zobuj/PortableOfflineTranslator/README.md

# Portable Offline Translator

Portable Offline Translator is a lightweight, offline translation tool designed for quick and easy translations without the need for an internet connection. 

Lab Notebooks are located in the [`doc/notebooks/`](./doc/notebooks/) directory.
