zobuj/PortableOfflineTranslator/doc/notebooks/lorenzo/images/lcd_initial.jpeg

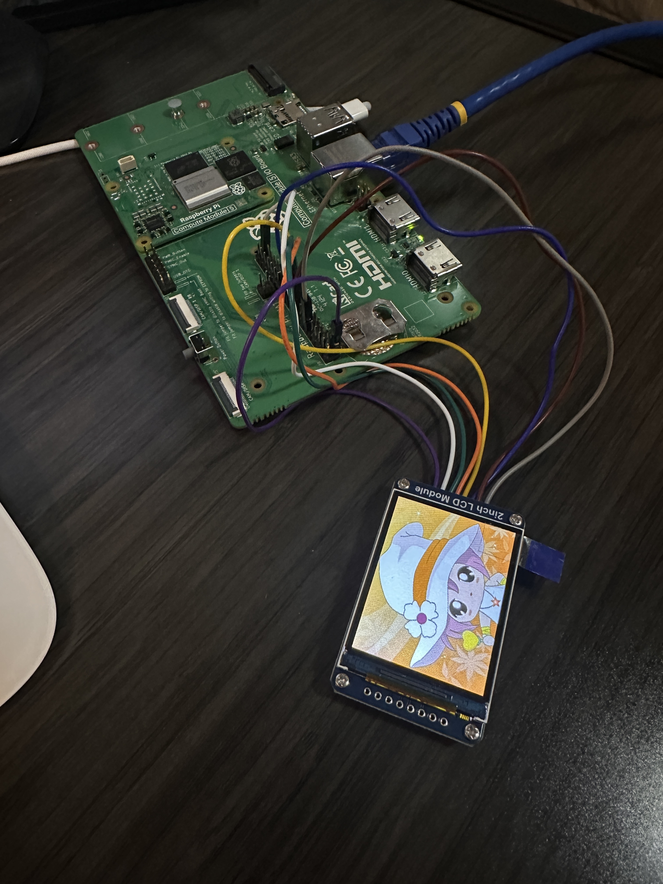
doc/notebooks/lorenzo/images/lcd_initial.jpeg
