zobuj/PortableOfflineTranslator/src/rspcm/images/io_GPIO_header.png

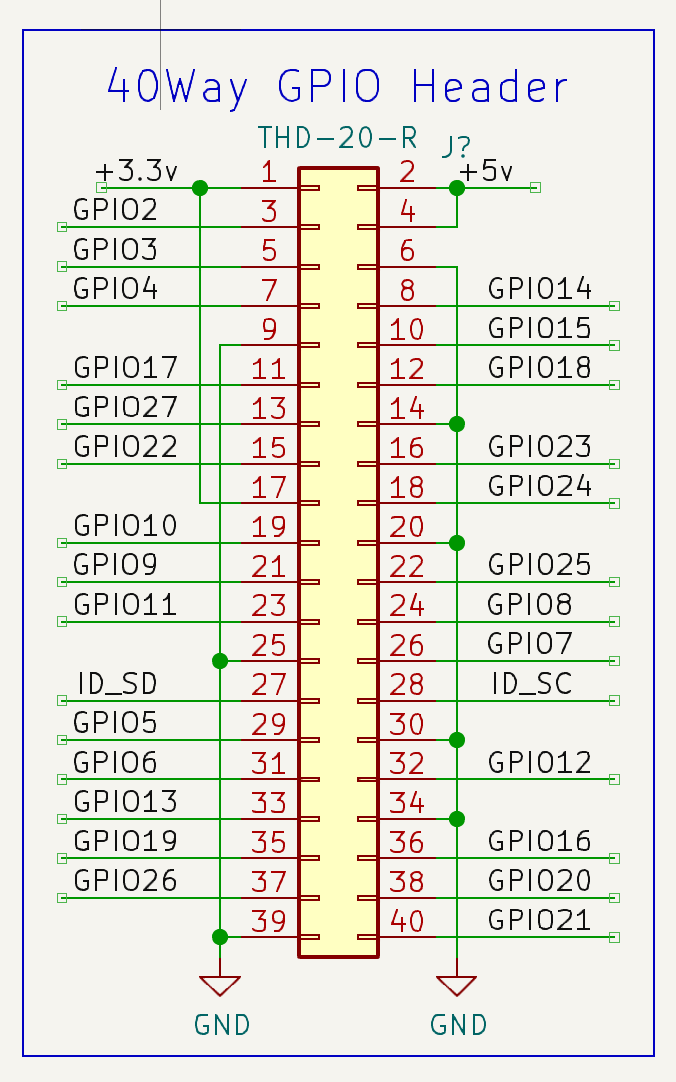
src/rspcm/images/io_GPIO_header.png
