zobuj/PortableOfflineTranslator/src/user_interface/lcd/images/output.bmp

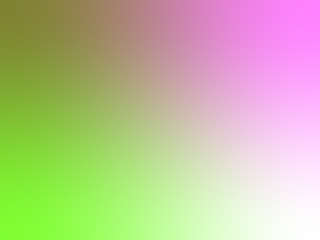
src/user_interface/lcd/images/output.bmp
