zobuj/PortableOfflineTranslator/pcb/PCB_Backup/Symbols:Footprints/ESP32_S3/ESP32-S3.step

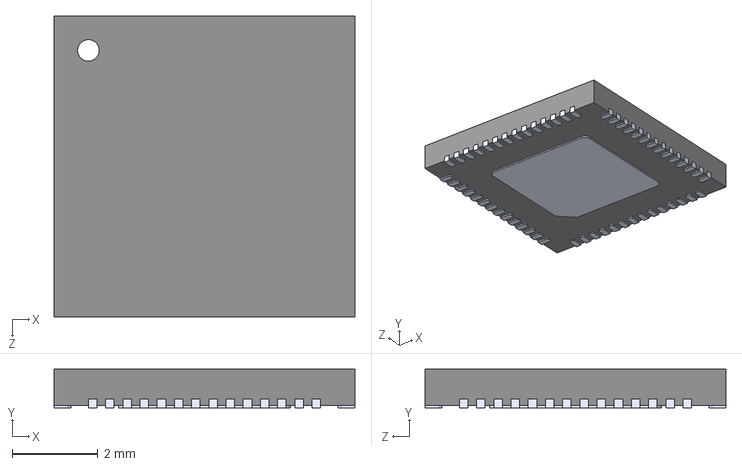
[picture p25: CAD file, 2025-05-08]
pcb/PCB_Backup/Symbols:Footprints/ESP32_S3/ESP32-S3.step
7.00 x 0.9 x 7.00 mm
