zobuj/PortableOfflineTranslator/pcb/PCB_Backup/Symbols:Footprints/ESP32_S3_WROOM_1_N8R8/ESP32-S3-WROOM-1-N8R8.step

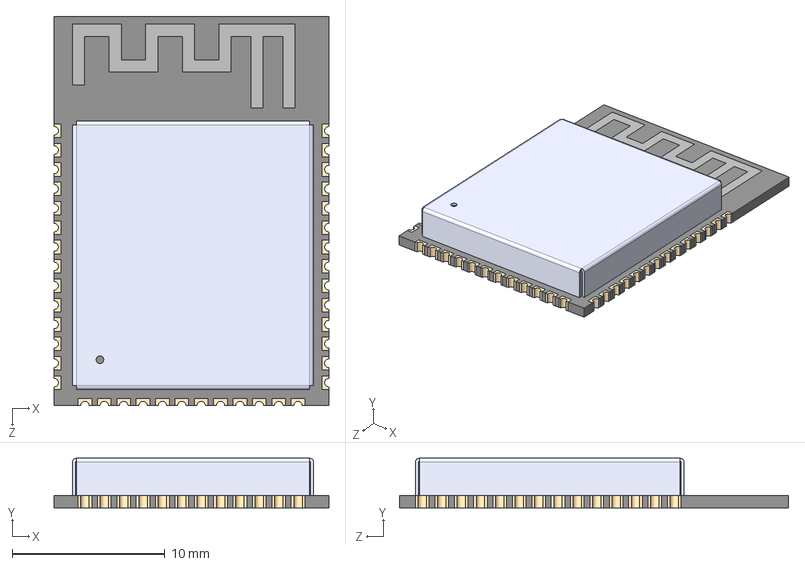
[picture p26: CAD file, 2025-05-08]
pcb/PCB_Backup/Symbols:Footprints/ESP32_S3_WROOM_1_N8R8/ESP32-S3-WROOM-1-N8R8.step
18.0 x 3.25 x 25.5 mm
