zobuj/PortableOfflineTranslator/pcb/Portable Offline Translator/Symbols/Battery Connector/B2B-XH-A.step

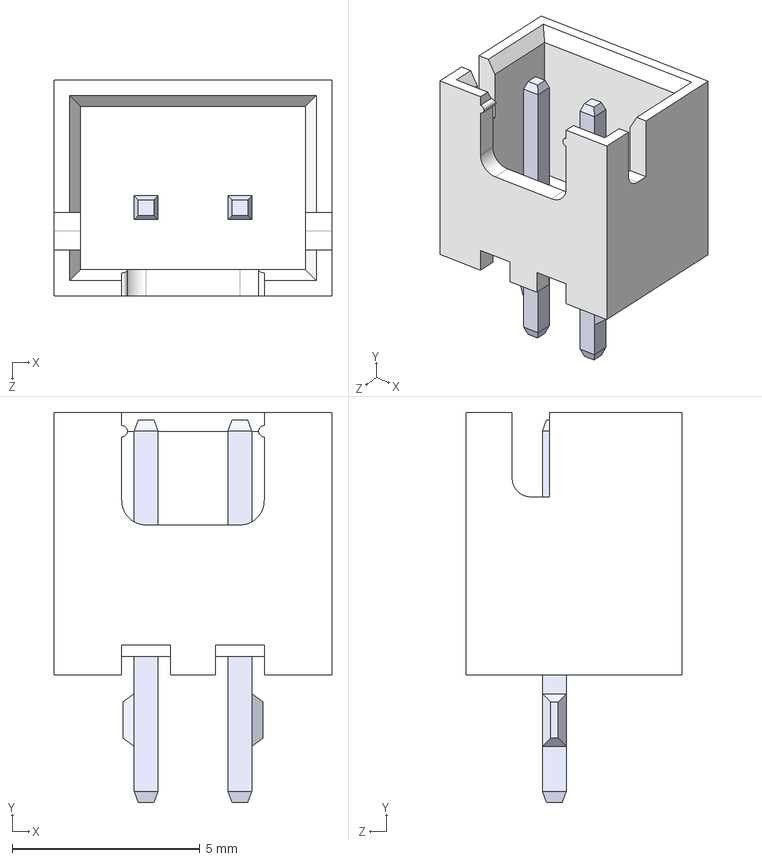
[picture p27: CAD file, 2025-04-03]
pcb/Portable Offline Translator/Symbols/Battery Connector/B2B-XH-A.step
7.40 x 10.4 x 5.75 mm
