zobuj/PortableOfflineTranslator/pcb/Portable Offline Translator/Symbols/SPH0645LM4H-B(Microphone)/SPH0645LM4H-B.step

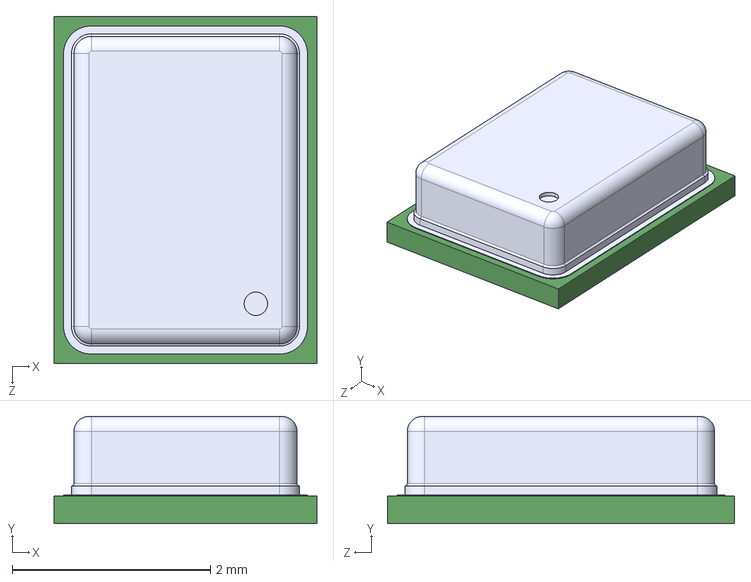
[picture p28: CAD file, 2025-04-03]
pcb/Portable Offline Translator/Symbols/SPH0645LM4H-B(Microphone)/SPH0645LM4H-B.step
2.65 x 1.08 x 3.50 mm
