zobuj/PortableOfflineTranslator/pcb/Portable Offline Translator/Symbols/CM5_Connector/10164227-1001A1RLF.step

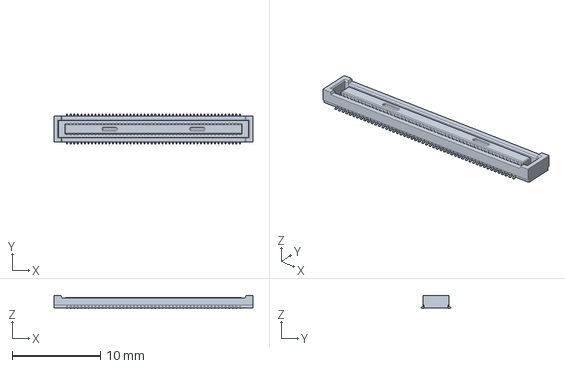
[picture p29: CAD file, 2025-03-11]
pcb/Portable Offline Translator/Symbols/CM5_Connector/10164227-1001A1RLF.step
22.6 x 3.38 x 1.45 mm
