zobuj/PortableOfflineTranslator/pcb/Portable Offline Translator/Symbols/MAX98357AETE_T/MAX98357AETE_T.step

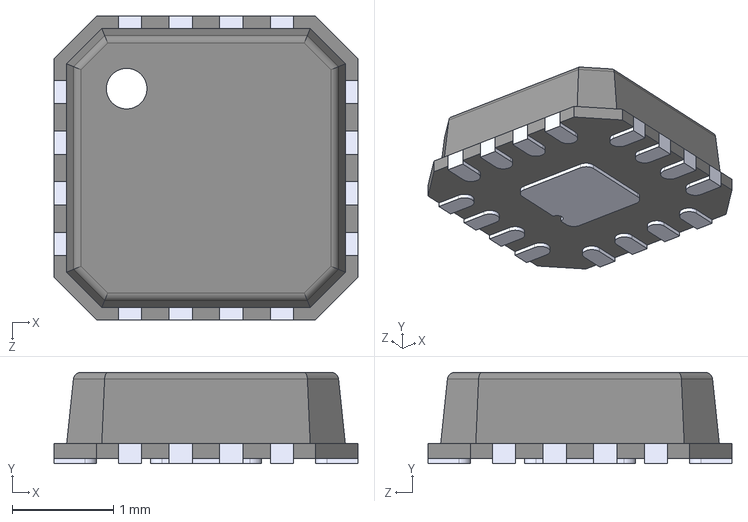
[picture p30: CAD file, 2025-03-22]
pcb/Portable Offline Translator/Symbols/MAX98357AETE_T/MAX98357AETE_T.step
3.00 x 0.9 x 3.00 mm
