zobuj/PortableOfflineTranslator/(list of files, cad)

Other CAD files:
pcb/Portable Offline Translator/Symbols/LIB_STM32F407IET6/STM32F407IET6/Allegro/qfp50p2600x2600x160-176n.psm
pcb/Portable Offline Translator/Symbols/LIB_STM32F407IET6/STM32F407IET6/DEHDL/stm32f407iet6/chips/chips.prt
