zobuj/PortableOfflineTranslator/output/pipeline_memory_usage_high.png

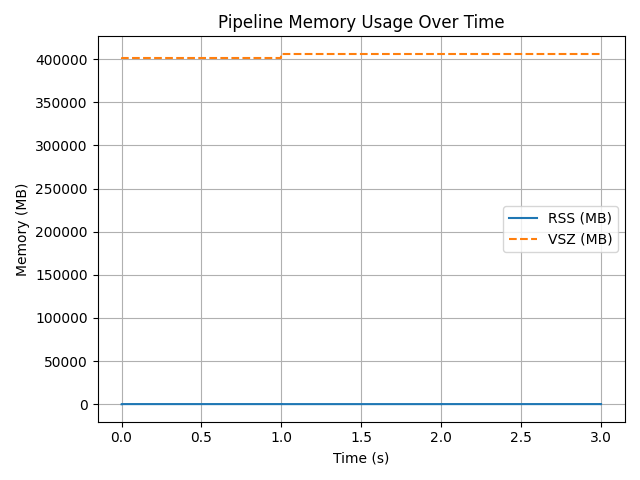
output/pipeline_memory_usage_high.png
