zobuj/PortableOfflineTranslator/pcb/PCB_Backup/PlanB/PlanB.kicad_pcb

## KiCad design pcb/PCB_Backup/PlanB/PlanB.kicad_pcb (2025-05-08)

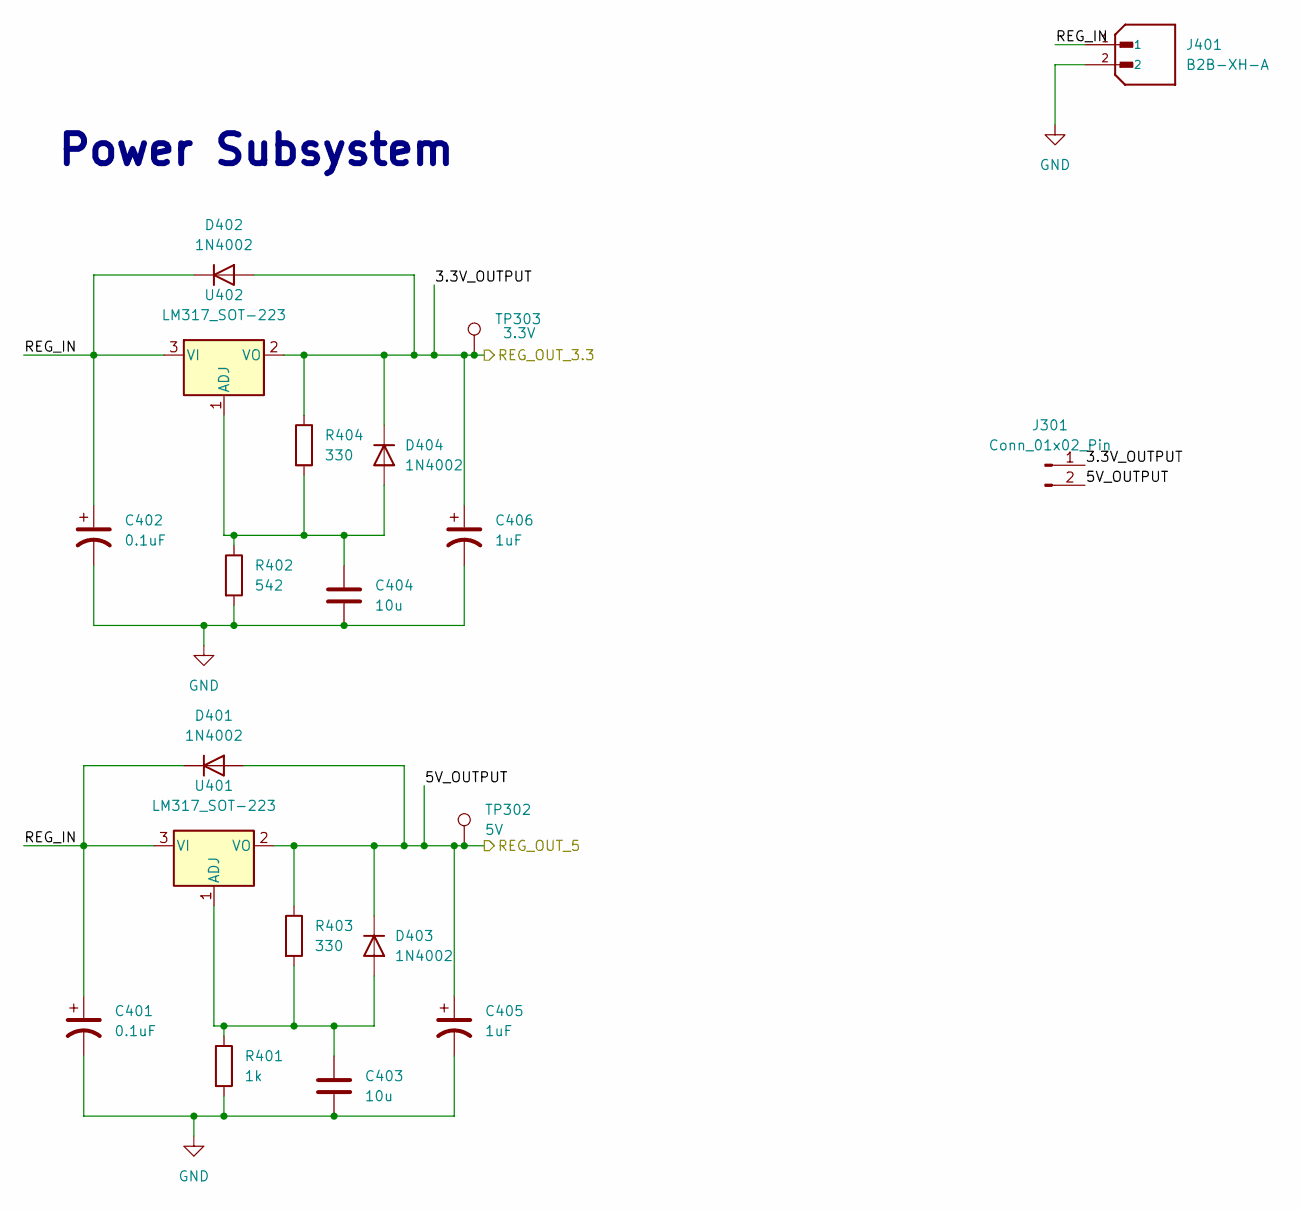
[picture p32: schematic PowerSS.kicad_sch]

Parts:
C401, C402: 0.1uF; C_0603_1608Metric_Pad1.08x0.95mm_HandSolder
C403, C404: 10u; C_0603_1608Metric_Pad1.08x0.95mm_HandSolder
C405, C406: 1uF; C_0603_1608Metric_Pad1.08x0.95mm_HandSolder
D401, D402, D403, D404: 1N4002; D_DO-41_SOD81_P10.16mm_Horizontal
J301: Conn_01x02_Pin; PinHeader_1x02_P2.54mm_Vertical
J401: B2B-XH-A; JST_B2B-XH-A; PARTREV N/A
R401: 1k; R_0805_2012Metric_Pad1.20x1.40mm_HandSolder
R402: 542; R_0805_2012Metric_Pad1.20x1.40mm_HandSolder
R403, R404: 330; R_0805_2012Metric_Pad1.20x1.40mm_HandSolder
TP302: 5V; TestPoint_Keystone_5000-5004_Miniature
TP303: 3.3V; TestPoint_Keystone_5000-5004_Miniature
U401, U402: LM317_SOT-223; SOT-223-3_TabPin2

Connections:
+3.3V: C406.1, D402.2 (A), D404.1 (K), J301.1, R404.1, TP303.1, U402.2 (VO); also elsewhere on the board
+5V: C405.1, D401.2 (A), D403.1 (K), J301.2, R403.1, TP302.1, U401.2 (VO)
/PowerSS/REG_IN: C401.1, C402.1, D401.1 (K), D402.1 (K), J401.1, U401.3 (VI), U402.3 (VI)
GND: C401.2, C402.2, C403.2, C404.2, C405.2, C406.2, J401.2, R401.2, R402.2; also elsewhere on the board
unnamed: C403.1, D403.2 (A), R401.1, R403.2, U401.1 (ADJ)
unnamed: C404.1, D404.2 (A), R402.1, R404.2, U402.1 (ADJ)

Notes on the sheet:
Power Subsystem

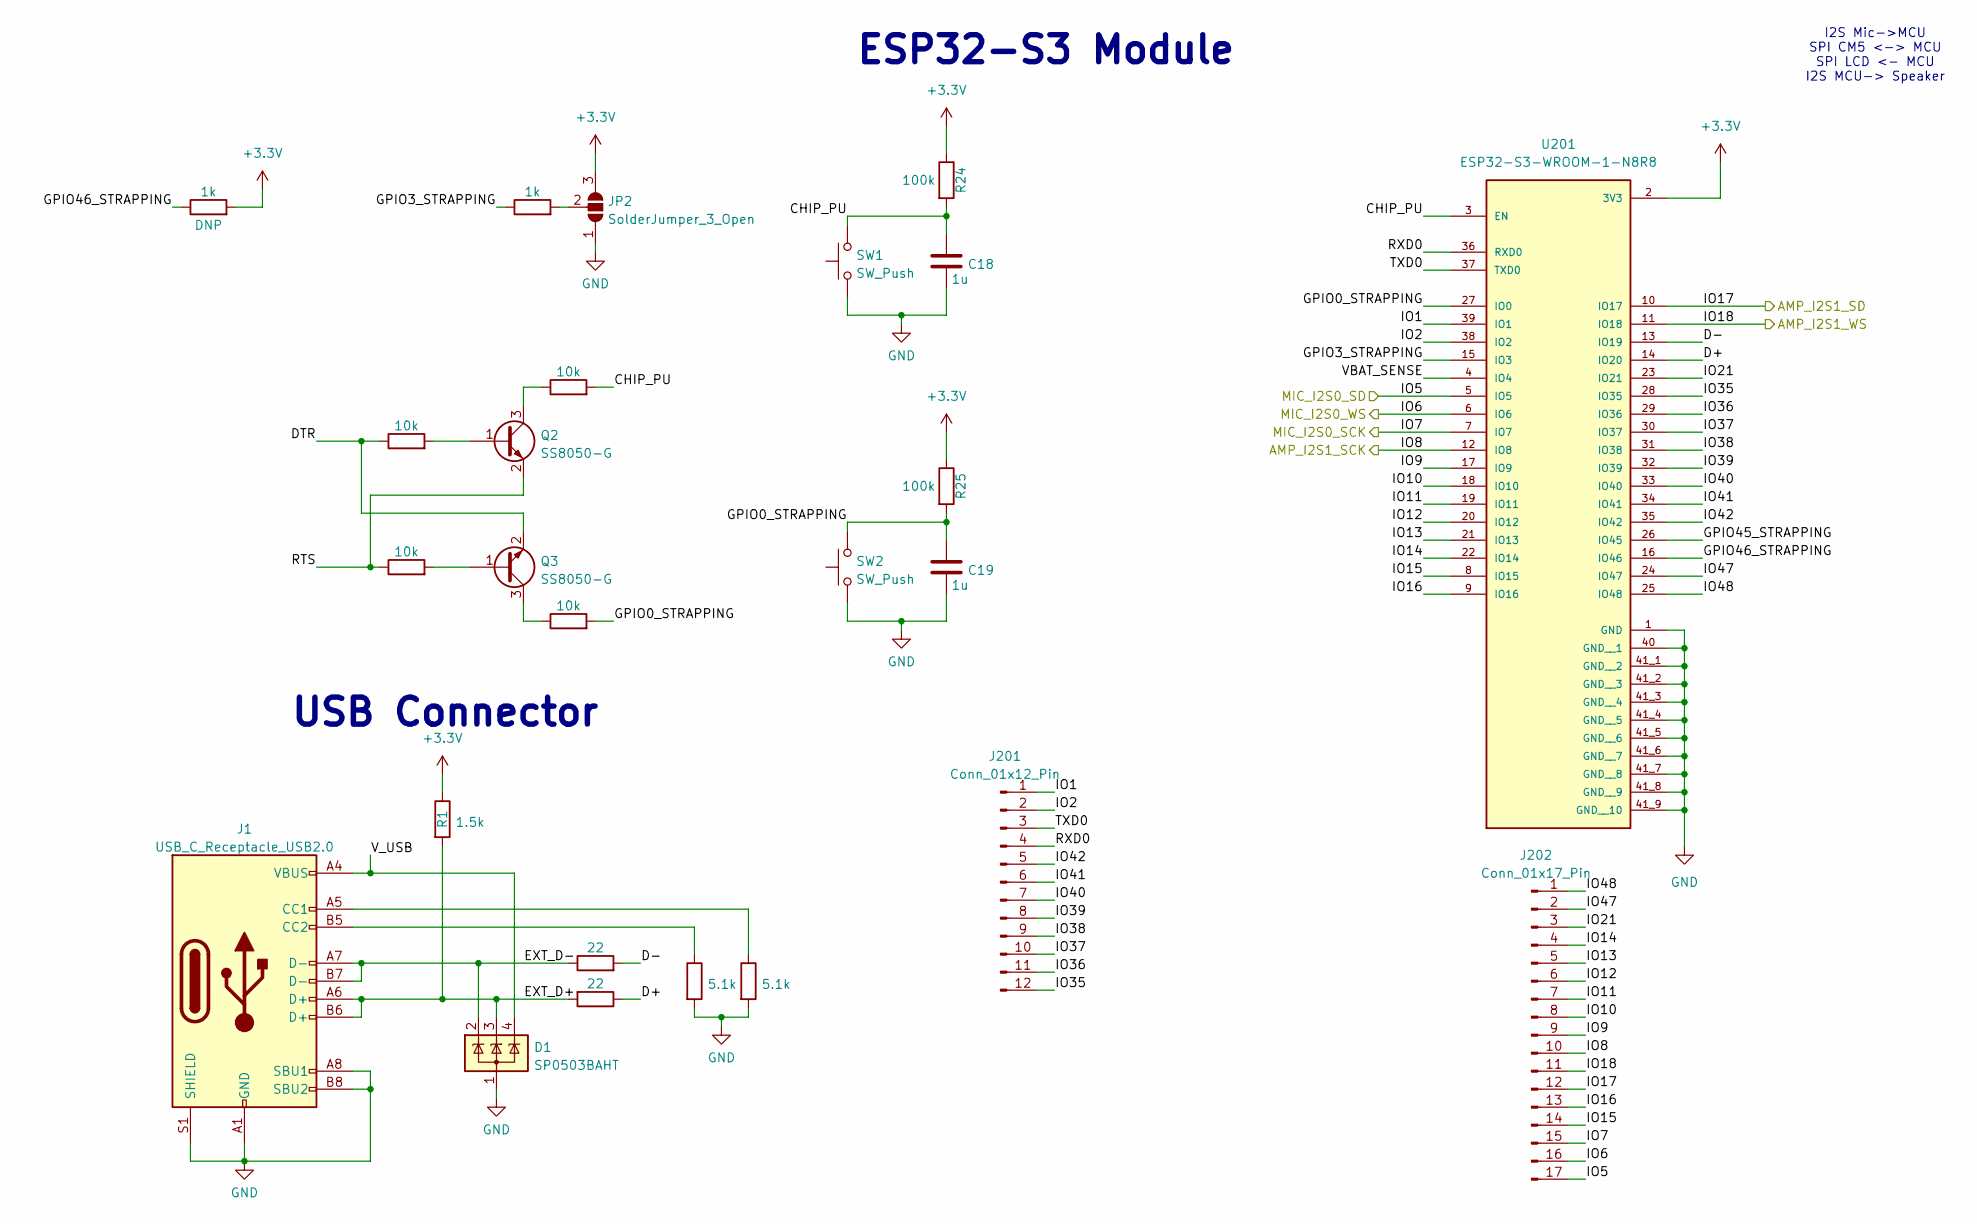
[picture p33: schematic MCU.kicad_sch]

Parts:
C18, C19: 1u; C_0805_2012Metric
D1: SP0503BAHT; SOT-143
J1: USB_C_Receptacle_USB2.0; USB_C_Receptacle_Amphenol_12401610E4-2A_CircularHoles
J201: Conn_01x12_Pin; PinSocket_1x12_P2.54mm_Vertical
J202: Conn_01x17_Pin; PinSocket_1x17_P2.54mm_Vertical
JP2: SolderJumper_3_Open; SolderJumper-3_P2.0mm_Open_TrianglePad1.0x1.5mm
Q2, Q3: SS8050-G; SOT-23
R1: 1.5k; R_0603_1608Metric
R3, R4: 22; R_0603_1608Metric
R7, R8: 5.1k; R_0603_1608Metric
R12, R17: 1k; R_0805_2012Metric
R13, R14, R18, R19: 10k; R_0805_2012Metric
R24, R25: 100k; R_0805_2012Metric
SW1, SW2: SW_Push; SW_SPST_B3S-1000
U201: ESP32-S3-WROOM-1-N8R8; XCVR_ESP32S3WROOM1N8R8

Connections:
+3.3V: JP2.3 (B), R1.1, R12.2, R24.1, R25.1, U201.2 (3V3); also elsewhere on the board
/MCU/CHIP_PU: C18.1, R18.2, R24.2, SW1.2, U201.3 (EN)
/MCU/D+: R4.1, U201.14 (IO20)
/MCU/D-: R3.2, U201.13 (IO19)
/MCU/DTR: Q3.2 (E), R13.1
/MCU/EXT_D+: D1.3 (K), J1.A6 (D+), J1.B6 (D+), R1.2, R4.2
/MCU/EXT_D-: D1.2 (K), J1.A7 (D-), J1.B7 (D-), R3.1
/MCU/GPIO0_STRAPPING: C19.1, R19.2, R25.2, SW2.2, U201.27 (IO0)
/MCU/GPIO3_STRAPPING: R17.1, U201.15 (IO3)
/MCU/GPIO45_STRAPPING: U201.26 (IO45)
/MCU/GPIO46_STRAPPING: R12.1, U201.16 (IO46)
/MCU/IO1: J201.1, U201.39 (IO1)
/MCU/IO2: J201.2, U201.38 (IO2)
/MCU/IO5: J202.17, U201.5 (IO5); also elsewhere on the board
/MCU/IO6: J202.16, U201.6 (IO6); also elsewhere on the board
/MCU/IO7: J202.15, U201.7 (IO7); also elsewhere on the board
/MCU/IO8: J202.10, U201.12 (IO8); also elsewhere on the board
/MCU/IO9: J202.9, U201.17 (IO9)
/MCU/IO10: J202.8, U201.18 (IO10)
/MCU/IO11: J202.7, U201.19 (IO11)
/MCU/IO12: J202.6, U201.20 (IO12)
/MCU/IO13: J202.5, U201.21 (IO13)
/MCU/IO14: J202.4, U201.22 (IO14)
/MCU/IO15: J202.14, U201.8 (IO15)
/MCU/IO16: J202.13, U201.9 (IO16)
/MCU/IO17: J202.12, U201.10 (IO17); also elsewhere on the board
/MCU/IO18: J202.11, U201.11 (IO18); also elsewhere on the board
/MCU/IO21: J202.3, U201.23 (IO21)
/MCU/IO35: J201.12, U201.28 (IO35)
/MCU/IO36: J201.11, U201.29 (IO36)
/MCU/IO37: J201.10, U201.30 (IO37)
/MCU/IO38: J201.9, U201.31 (IO38)
/MCU/IO39: J201.8, U201.32 (IO39)
/MCU/IO40: J201.7, U201.33 (IO40)
/MCU/IO41: J201.6, U201.34 (IO41)
/MCU/IO42: J201.5, U201.35 (IO42)
/MCU/IO47: J202.2, U201.24 (IO47)
/MCU/IO48: J202.1, U201.25 (IO48)
/MCU/RTS: Q2.2 (E), R14.1
/MCU/RXD0: J201.4, U201.36 (RXD0)
/MCU/TXD0: J201.3, U201.37 (TXD0)
/MCU/VBAT_SENSE: U201.4 (IO4)
/MCU/V_USB: D1.4 (K), J1.A4 (VBUS), J1.A9 (VBUS), J1.B4 (VBUS), J1.B9 (VBUS)
GND: C18.2, C19.2, D1.1 (A), J1.A1 (GND), J1.A8 (SBU1), J1.A12 (GND), J1.B1 (GND), J1.B8 (SBU2), J1.B12 (GND), J1.S1 (SHIELD), JP2.1 (A), R7.2, R8.2, SW1.1, SW2.1, U201.1 (GND), U201.40 (GND__1), U201.41_1 (GND__2), U201.41_2 (GND__3), U201.41_3 (GND__4), U201.41_4 (GND__5), U201.41_5 (GND__6), U201.41_6 (GND__7), U201.41_7 (GND__8), U201.41_8 (GND__9), U201.41_9 (GND__10); also elsewhere on the board
unnamed: J1.A5 (CC1), R8.1
unnamed: J1.B5 (CC2), R7.1
unnamed: JP2.2 (C), R17.2
unnamed: Q2.1 (B), R13.2
unnamed: Q2.3 (C), R18.1
unnamed: Q3.1 (B), R14.2
unnamed: Q3.3 (C), R19.1

Notes on the sheet:
I2S Mic->MCU SPI CM5 <-> MCU SPI LCD <- MCU I2S MCU-> Speaker
ESP32-S3 Module
USB Connector

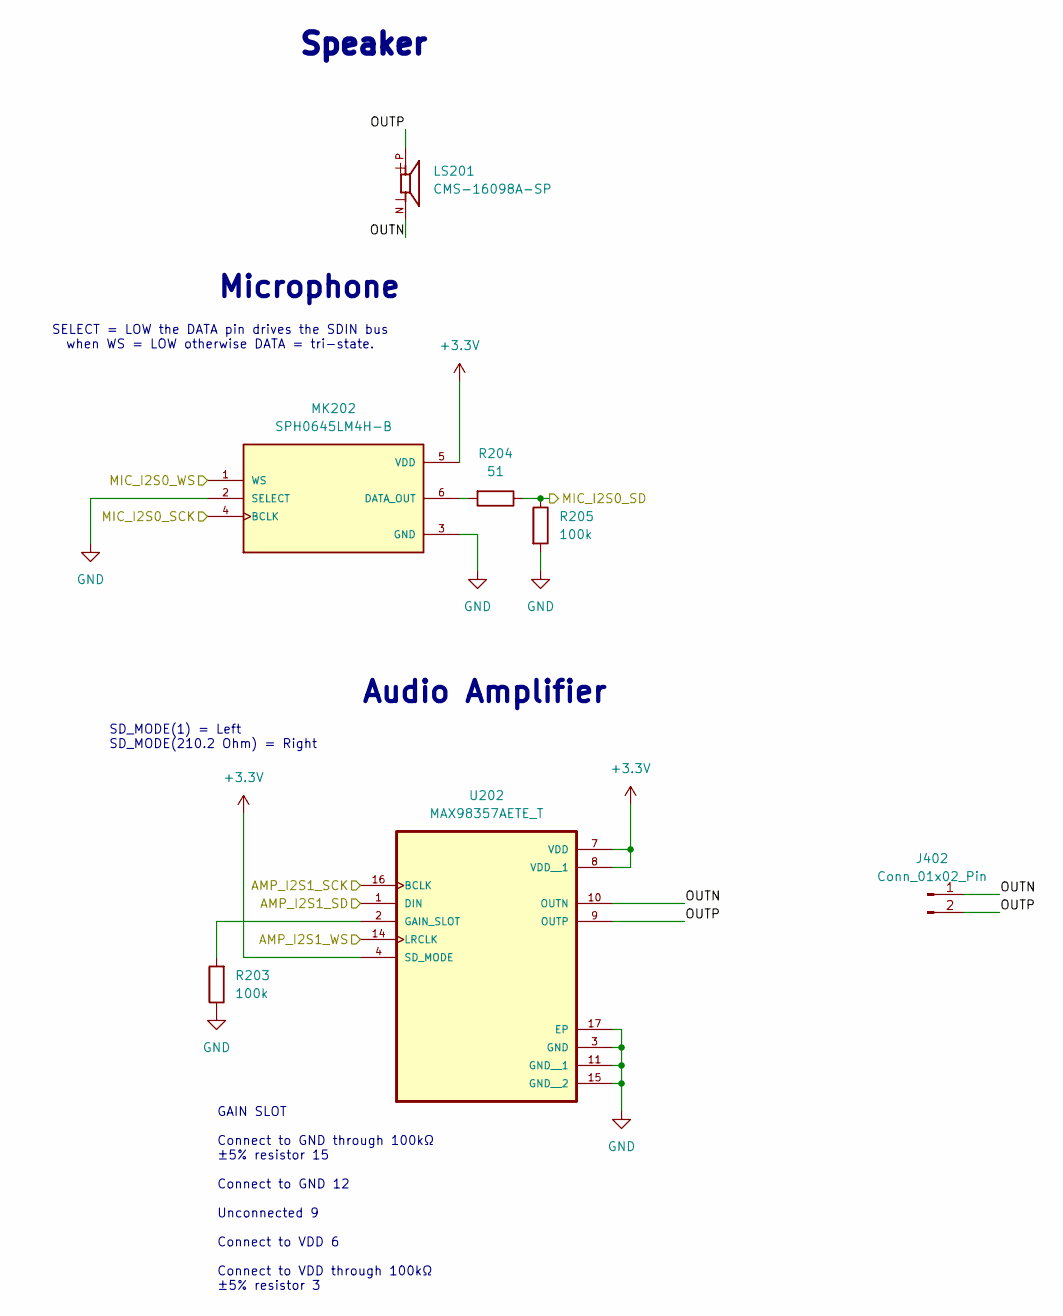
[picture p34: schematic IO.kicad_sch]

Parts:
J402: Conn_01x02_Pin; PinHeader_1x02_P2.54mm_Vertical
LS201: CMS-16098A-SP; CUI_CMS-16098A-SP
MK202: SPH0645LM4H-B; MIC_SPH0645LM4H-B
R203, R205: 100k; R_0805_2012Metric_Pad1.20x1.40mm_HandSolder
R204: 51; R_0805_2012Metric_Pad1.20x1.40mm_HandSolder
U202: MAX98357AETE_T; TQFN-16-1EP_3x3mm_P0.5mm_EP1.23x1.23mm

Connections:
+3.3V: MK202.5 (VDD), U202.4 (SD_MODE), U202.7 (VDD), U202.8 (VDD__1); also elsewhere on the board
/IO/OUTN: J402.1, LS201.N, U202.10 (OUTN)
/IO/OUTP: J402.2, LS201.P, U202.9 (OUTP)
/MCU/IO5: R204.1, R205.1; also elsewhere on the board
/MCU/IO6: MK202.1 (WS); also elsewhere on the board
/MCU/IO7: MK202.4 (BCLK); also elsewhere on the board
/MCU/IO8: U202.16 (BCLK); also elsewhere on the board
/MCU/IO17: U202.1 (DIN); also elsewhere on the board
/MCU/IO18: U202.14 (LRCLK); also elsewhere on the board
GND: MK202.2 (SELECT), MK202.3 (GND), R203.1, R205.2, U202.3 (GND), U202.11 (GND__1), U202.15 (GND__2), U202.17 (EP); also elsewhere on the board
unnamed: MK202.6 (DATA_OUT), R204.2
unnamed: R203.2, U202.2 (GAIN_SLOT)

Notes on the sheet:
Speaker
SELECT = LOW the DATA pin drives the SDIN bus when WS = LOW otherwise DATA = tri-state.
Audio Amplifier
Microphone
GAIN SLOT Connect to GND through 100kΩ ±5% resistor 15 Connect to GND 12 Unconnected 9 Connect to VDD 6 Connect to VDD through 100kΩ ±5% resistor 3
SD_MODE(1) = Left SD_MODE(210.2 Ohm) = Right

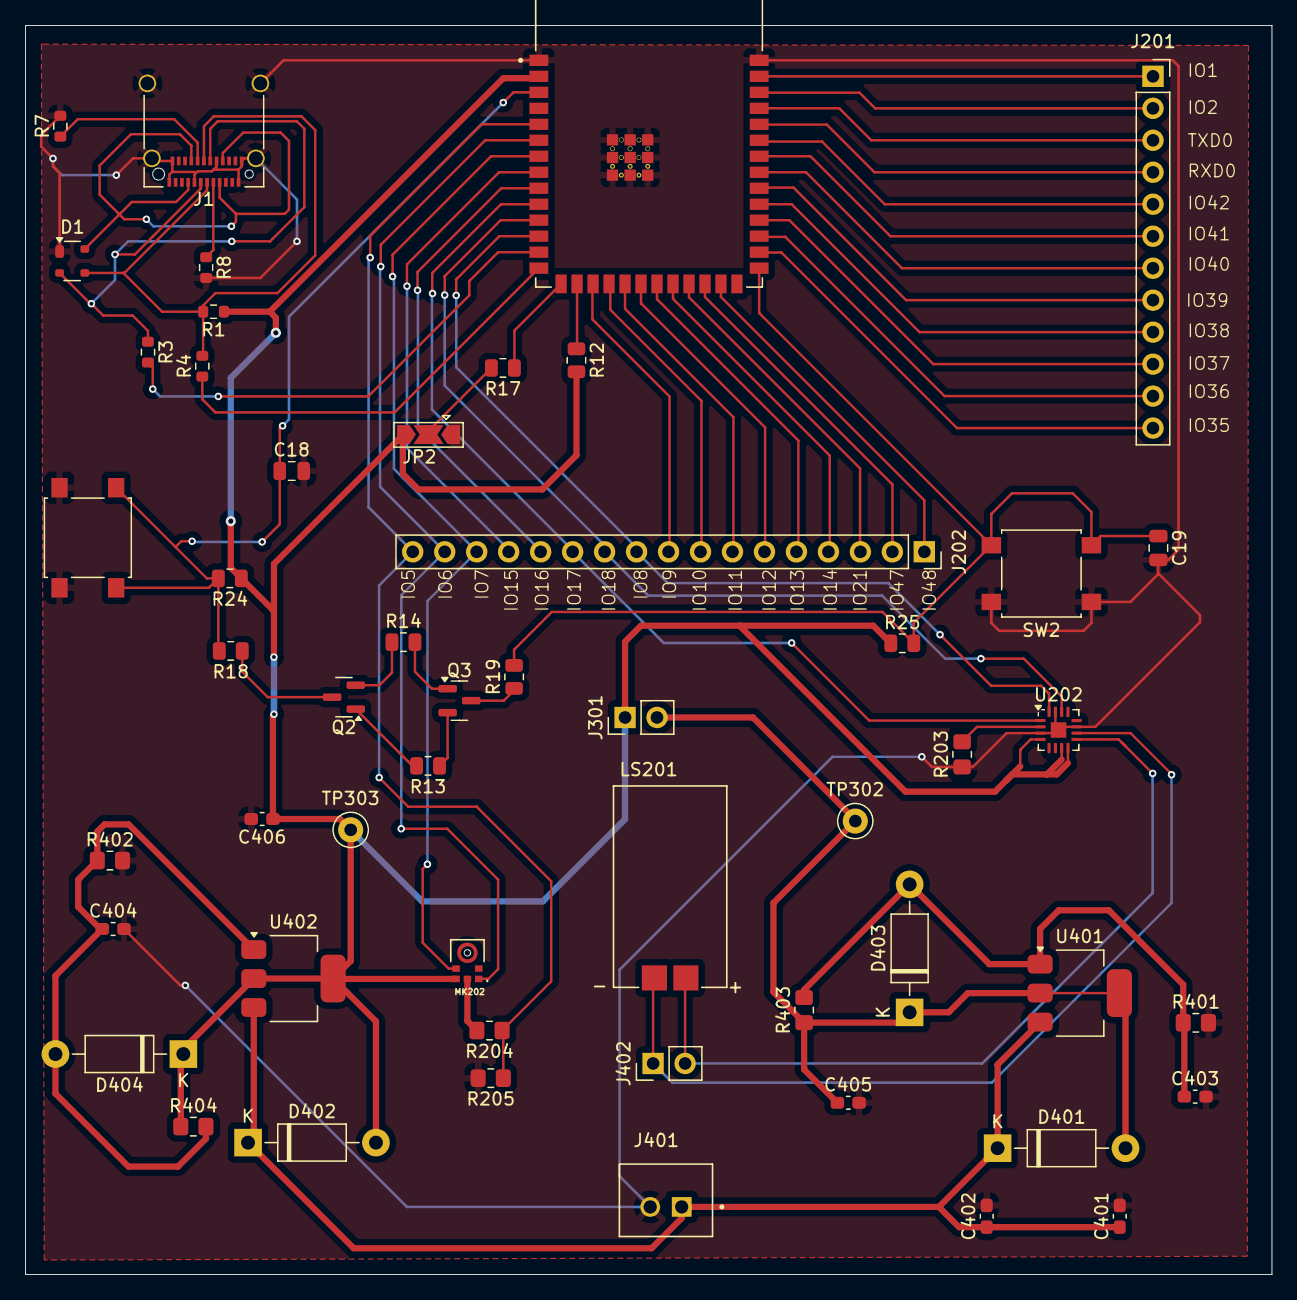
[picture p35: board PlanB.kicad_pcb from above]

Board: 2 copper layers, 99.0 x 99.2 mm, 52 parts (0 on the bottom side), 57 nets.
