zobuj/PortableOfflineTranslator/pcb/Portable Offline Translator/Portable Offline Translator.kicad_pcb

## KiCad design pcb/Portable Offline Translator/Portable Offline Translator.kicad_pcb (2025-04-03)

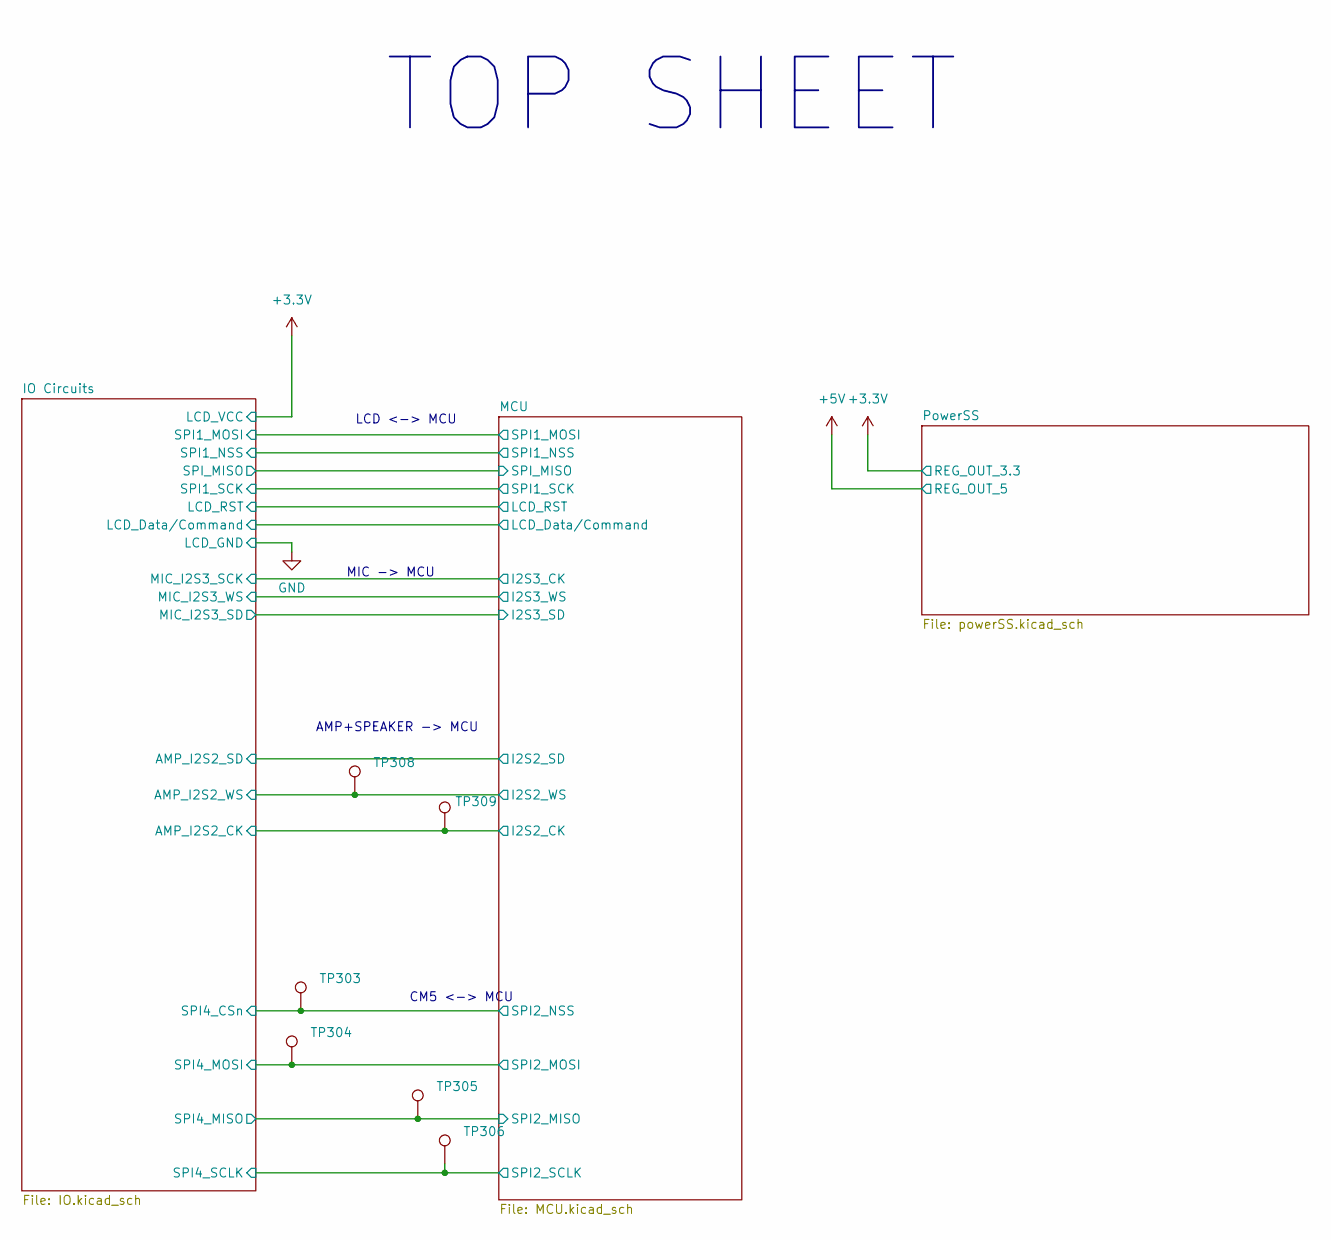
[picture p36: schematic Portable Offline Translator.kicad_sch]

Parts:
TP303: SPI4_CSn; TestPoint_Keystone_5000-5004_Miniature
TP304: SPI4_MOSI; TestPoint_Keystone_5000-5004_Miniature
TP305: SPI4_MISO; TestPoint_Keystone_5000-5004_Miniature
TP306: SPI4_SCLK; TestPoint_Keystone_5000-5004_Miniature
TP308: I2S_CLK; TestPoint_Keystone_5000-5004_Miniature
TP309: 3.3V; TestPoint_Keystone_5000-5004_Miniature

Connections:
/IO Circuits/AMP_I2S2_CK: TP309.1; also elsewhere on the board
/IO Circuits/AMP_I2S2_WS: TP308.1; also elsewhere on the board
/IO Circuits/SPI4_CSn: TP303.1; also elsewhere on the board
/IO Circuits/SPI4_MISO: TP305.1; also elsewhere on the board
/IO Circuits/SPI4_MOSI: TP304.1; also elsewhere on the board
/IO Circuits/SPI4_SCLK: TP306.1; also elsewhere on the board

Notes on the sheet:
AMP+SPEAKER -> MCU
CM5 <-> MCU
MIC -> MCU
TOP SHEET
LCD <-> MCU

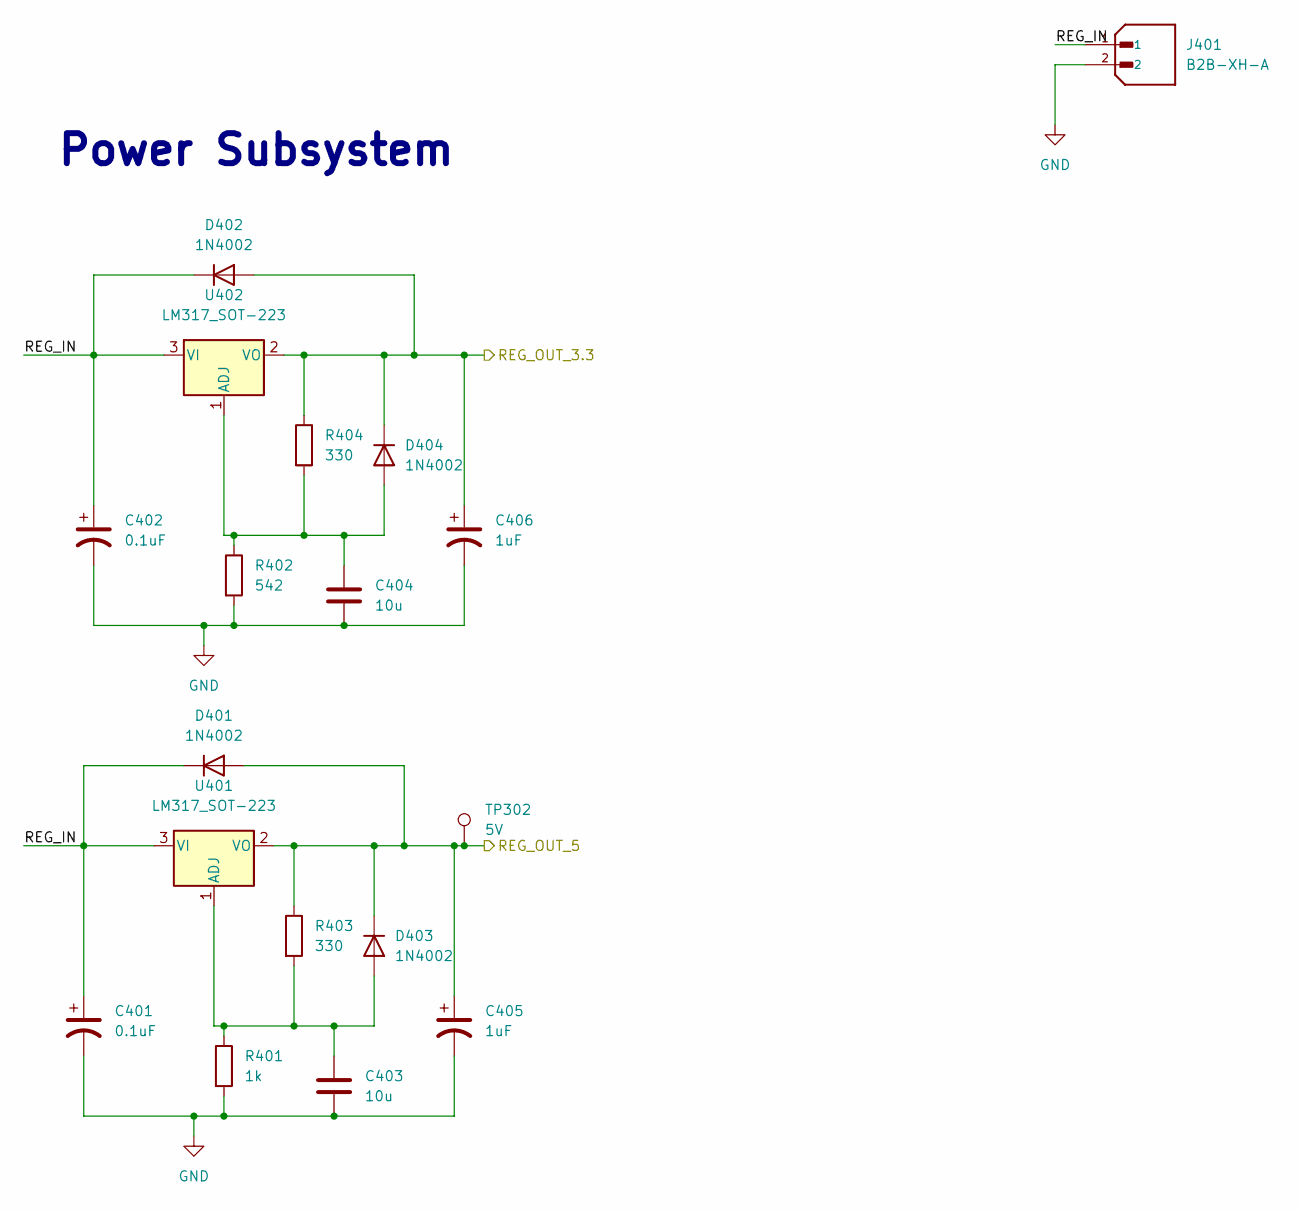
[picture p37: schematic powerSS.kicad_sch]

Parts:
C401, C402: 0.1uF; C_0603_1608Metric_Pad1.08x0.95mm_HandSolder
C403, C404: 10u; C_0603_1608Metric_Pad1.08x0.95mm_HandSolder
C405, C406: 1uF; C_0603_1608Metric_Pad1.08x0.95mm_HandSolder
D401, D402, D403, D404: 1N4002; D_DO-41_SOD81_P10.16mm_Horizontal
J401: B2B-XH-A; JST_B2B-XH-A; PARTREV N/A
R401: 1k; R_0805_2012Metric_Pad1.20x1.40mm_HandSolder
R402: 542; R_0805_2012Metric_Pad1.20x1.40mm_HandSolder
R403, R404: 330; R_0805_2012Metric_Pad1.20x1.40mm_HandSolder
TP302: 5V; TestPoint_Keystone_5000-5004_Miniature
U401, U402: LM317_SOT-223; SOT-223-3_TabPin2

Connections:
+3.3V: C406.1, D402.2 (A), D404.1 (K), R404.1, U402.2 (VO); also elsewhere on the board
+5V: C405.1, D401.2 (A), D403.1 (K), R403.1, TP302.1, U401.2 (VO); also elsewhere on the board
/PowerSS/REG_IN: C401.1, C402.1, D401.1 (K), D402.1 (K), J401.1, U401.3 (VI), U402.3 (VI)
GND: C401.2, C402.2, C403.2, C404.2, C405.2, C406.2, J401.2, R401.2, R402.2; also elsewhere on the board
unnamed: C403.1, D403.2 (A), R401.1, R403.2, U401.1 (ADJ)
unnamed: C404.1, D404.2 (A), R402.1, R404.2, U402.1 (ADJ)

Notes on the sheet:
Power Subsystem

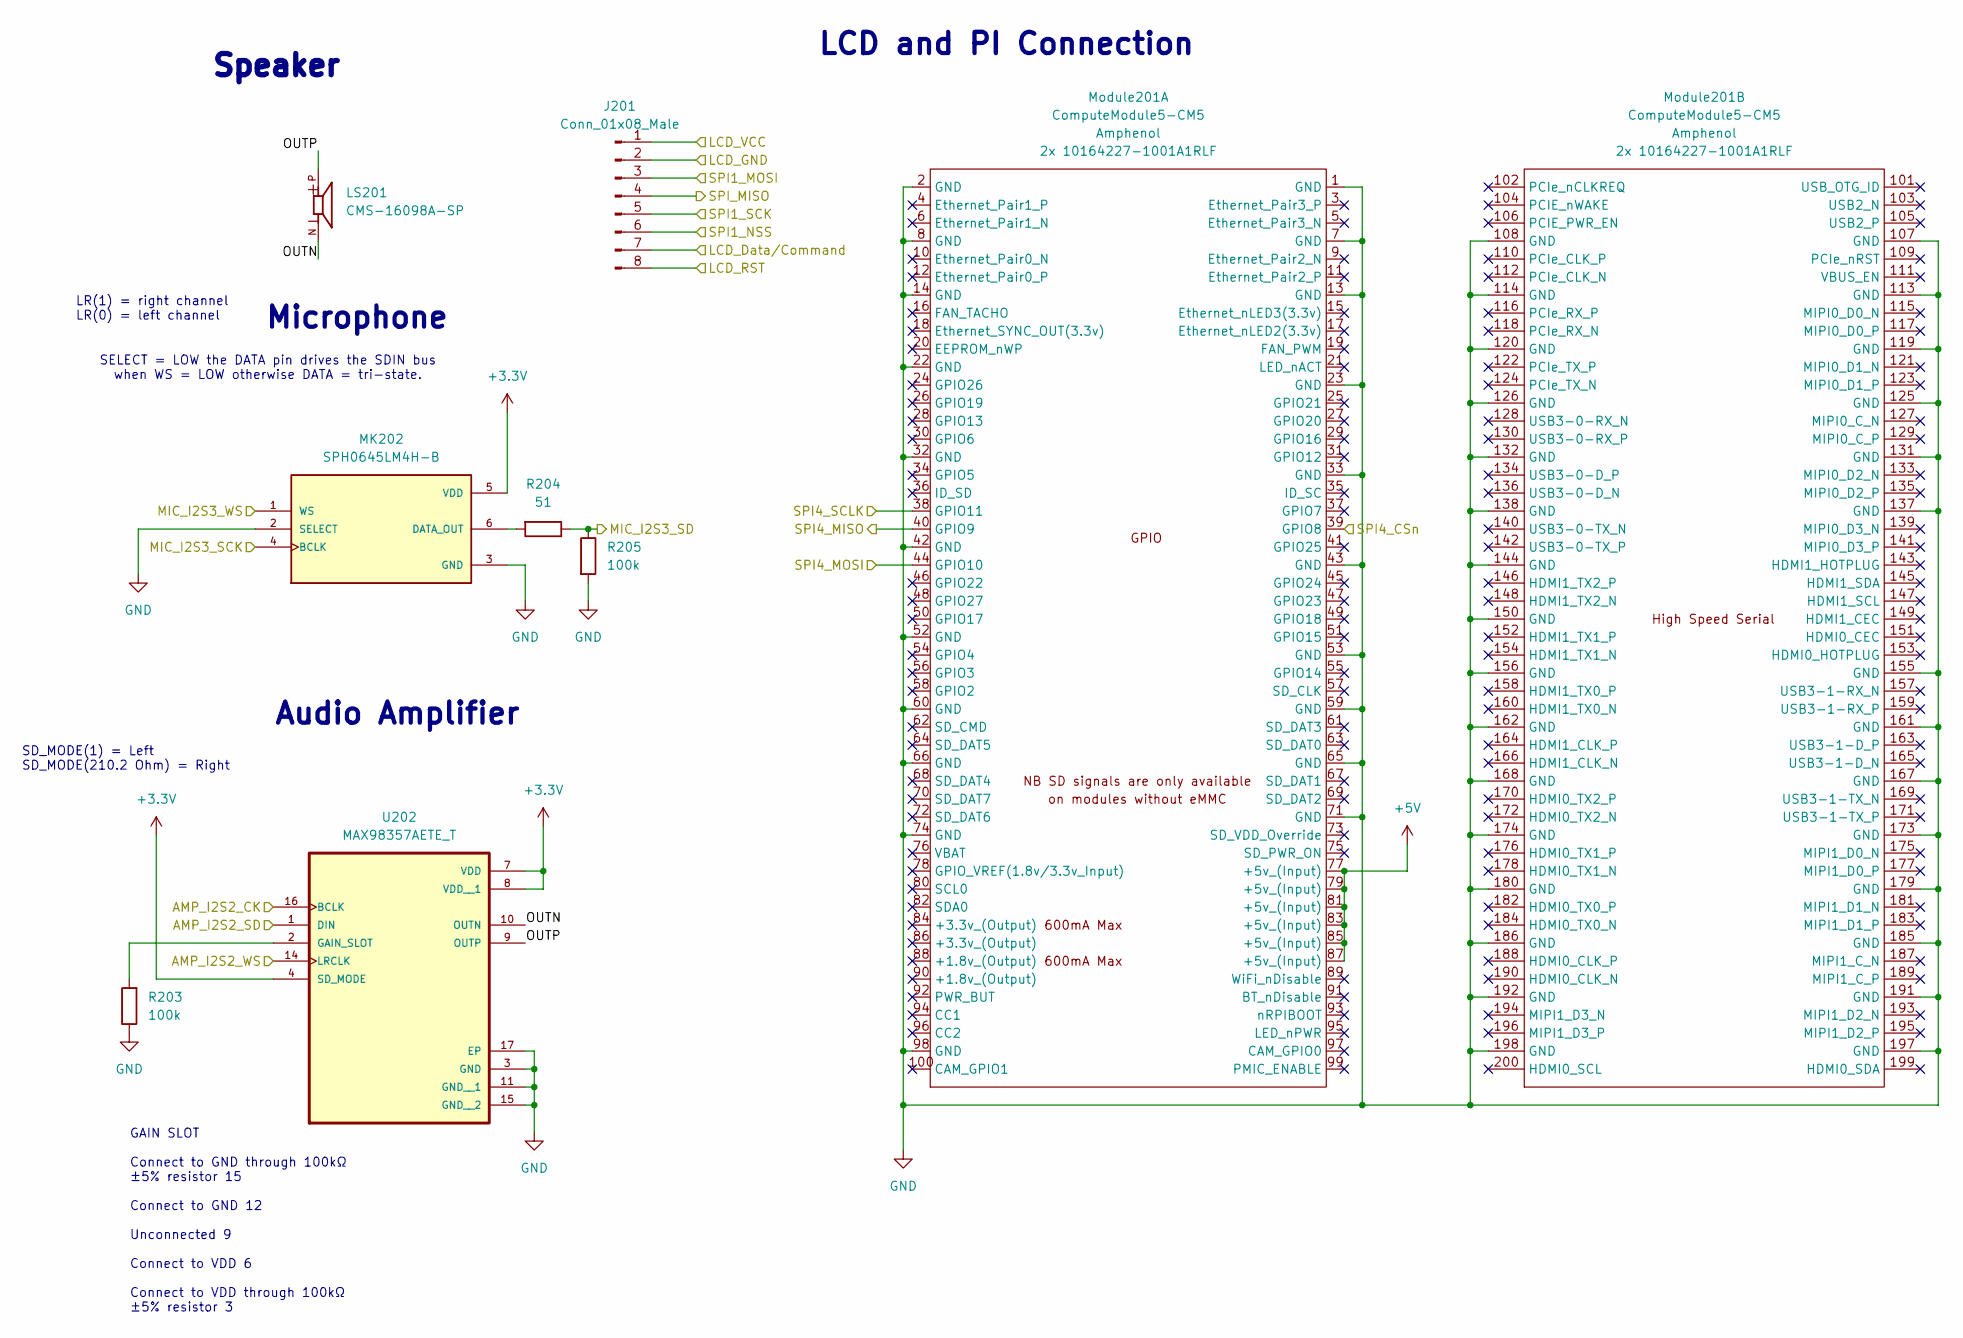
[picture p38: schematic IO.kicad_sch]

Parts:
J201: Conn_01x08_Male; PinSocket_1x08_P2.54mm_Vertical
LS201: CMS-16098A-SP; CUI_CMS-16098A-SP
MK202: SPH0645LM4H-B; MIC_SPH0645LM4H-B
Module201: ComputeModule5-CM5; Raspberry-Pi-5-Compute-Module
R203, R205: 100k; R_0805_2012Metric_Pad1.20x1.40mm_HandSolder
R204: 51; R_0805_2012Metric_Pad1.20x1.40mm_HandSolder
U202: MAX98357AETE_T; TQFN-16-1EP_3x3mm_P0.5mm_EP1.23x1.23mm

Connections:
+3.3V: J201.1, MK202.5 (VDD), U202.4 (SD_MODE), U202.7 (VDD), U202.8 (VDD__1); also elsewhere on the board
+5V: Module201.77 (+5v_(Input)), Module201.79 (+5v_(Input)), Module201.81 (+5v_(Input)), Module201.83 (+5v_(Input)), Module201.85 (+5v_(Input)), Module201.87 (+5v_(Input)); also elsewhere on the board
/IO Circuits/AMP_I2S2_CK: U202.16 (BCLK); also elsewhere on the board
/IO Circuits/AMP_I2S2_SD: U202.1 (DIN); also elsewhere on the board
/IO Circuits/AMP_I2S2_WS: U202.14 (LRCLK); also elsewhere on the board
/IO Circuits/LCD_Data/Command: J201.7; also elsewhere on the board
/IO Circuits/LCD_RST: J201.8; also elsewhere on the board
/IO Circuits/MIC_I2S3_SCK: MK202.4 (BCLK); also elsewhere on the board
/IO Circuits/MIC_I2S3_SD: R204.1, R205.1; also elsewhere on the board
/IO Circuits/MIC_I2S3_WS: MK202.1 (WS); also elsewhere on the board
/IO Circuits/OUTN: LS201.N, U202.10 (OUTN)
/IO Circuits/OUTP: LS201.P, U202.9 (OUTP)
/IO Circuits/SPI1_MOSI: J201.3; also elsewhere on the board
/IO Circuits/SPI1_NSS: J201.6; also elsewhere on the board
/IO Circuits/SPI1_SCK: J201.5; also elsewhere on the board
/IO Circuits/SPI4_CSn: Module201.39 (GPIO8); also elsewhere on the board
/IO Circuits/SPI4_MISO: Module201.40 (GPIO9); also elsewhere on the board
/IO Circuits/SPI4_MOSI: Module201.44 (GPIO10); also elsewhere on the board
/IO Circuits/SPI4_SCLK: Module201.38 (GPIO11); also elsewhere on the board
/IO Circuits/SPI_MISO: J201.4; also elsewhere on the board
GND: J201.2, MK202.2 (SELECT), MK202.3 (GND), Module201.1 (GND), Module201.2 (GND), Module201.7 (GND), Module201.8 (GND), Module201.13 (GND), Module201.14 (GND), Module201.22 (GND), Module201.23 (GND), Module201.32 (GND), Module201.33 (GND), Module201.42 (GND), Module201.43 (GND), Module201.52 (GND), Module201.53 (GND), Module201.59 (GND), Module201.60 (GND), Module201.65 (GND), Module201.66 (GND), Module201.71 (GND), Module201.74 (GND), Module201.98 (GND), Module201.107 (GND), Module201.108 (GND), Module201.113 (GND), Module201.114 (GND), Module201.119 (GND), Module201.120 (GND), Module201.125 (GND), Module201.126 (GND), Module201.131 (GND), Module201.132 (GND), Module201.137 (GND), Module201.138 (GND), Module201.144 (GND), Module201.150 (GND), Module201.155 (GND), Module201.156 (GND), Module201.161 (GND), Module201.162 (GND), Module201.167 (GND), Module201.168 (GND), Module201.173 (GND), Module201.174 (GND), Module201.179 (GND), Module201.180 (GND), Module201.185 (GND), Module201.186 (GND), Module201.191 (GND), Module201.192 (GND), Module201.197 (GND), Module201.198 (GND), R203.1, R205.2, U202.3 (GND), U202.11 (GND__1), U202.15 (GND__2), U202.17 (EP); also elsewhere on the board
unnamed: MK202.6 (DATA_OUT), R204.2
unnamed: R203.2, U202.2 (GAIN_SLOT)

Notes on the sheet:
GAIN SLOT Connect to GND through 100kΩ ±5% resistor 15 Connect to GND 12 Unconnected 9 Connect to VDD 6 Connect to VDD through 100kΩ ±5% resistor 3
SELECT = LOW the DATA pin drives the SDIN bus when WS = LOW otherwise DATA = tri-state.
SD_MODE(1) = Left SD_MODE(210.2 Ohm) = Right
Audio Amplifier
Microphone
LCD and PI Connection
LR(1) = right channel LR(0) = left channel
Speaker
