zobuj/PortableOfflineTranslator/pcb/Portable Offline Translator/Portable Offline Translator.kicad_pcb

## KiCad design pcb/Portable Offline Translator/Portable Offline Translator.kicad_pcb (continued)

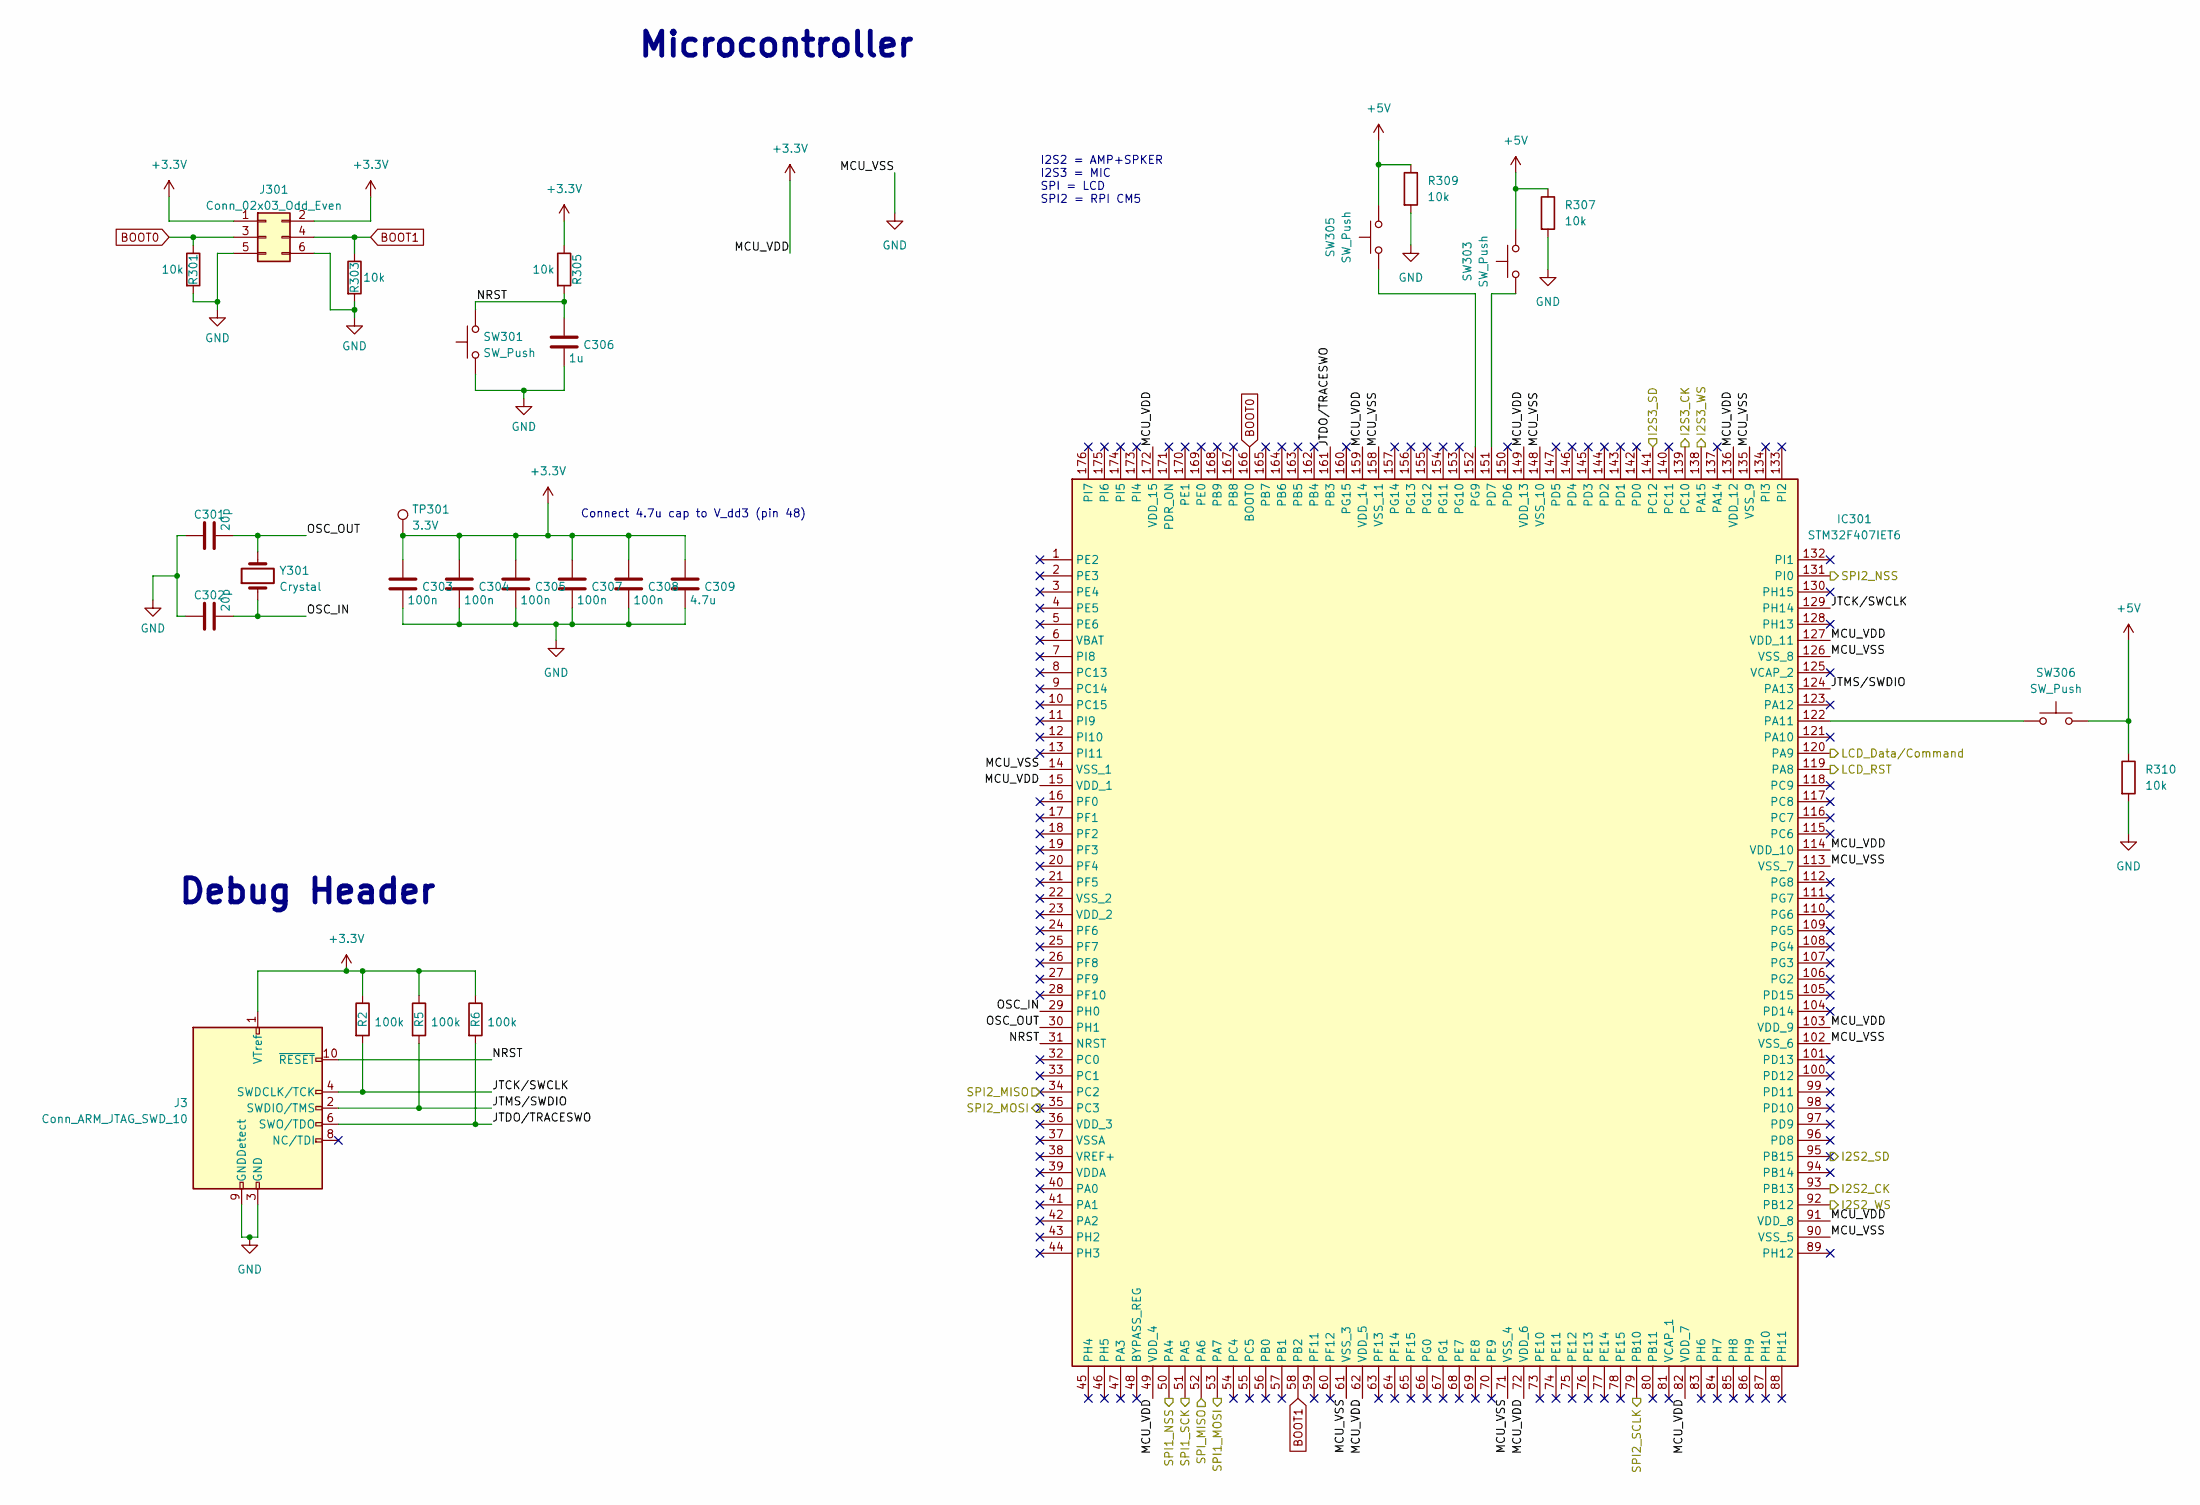
[picture p39: schematic MCU.kicad_sch]

Parts:
C301, C302: 20p; C_0603_1608Metric_Pad1.08x0.95mm_HandSolder
C303, C304, C305, C307, C308: 100n; C_0603_1608Metric_Pad1.08x0.95mm_HandSolder
C306: 1u; C_0603_1608Metric_Pad1.08x0.95mm_HandSolder
C309: 4.7u; C_0603_1608Metric_Pad1.08x0.95mm_HandSolder
IC301: STM32F407IET6; LQFP-176_24x24mm_P0.5mm; Mouser Part Number 511-STM32F407IET6
J3: Conn_ARM_JTAG_SWD_10; IDC-Header_2x05_P2.54mm_Vertical
J301: Conn_02x03_Odd_Even; PinSocket_2x03_P2.54mm_Vertical
R2, R5, R6: 100k; R_0805_2012Metric_Pad1.20x1.40mm_HandSolder
R301, R303, R305, R307, R309, R310: 10k; R_0805_2012Metric_Pad1.20x1.40mm_HandSolder
SW301, SW303, SW305, SW306: SW_Push; SW_SPST_B3S-1000
TP301: 3.3V; TestPoint_Keystone_5000-5004_Miniature
Y301: Crystal; Crystal_HC49-U_Vertical

Connections:
+3.3V: C303.1, C304.1, C305.1, C307.1, C308.1, C309.1, IC301.15 (VDD_1), IC301.49 (VDD_4), IC301.62 (VDD_5), IC301.72 (VDD_6), IC301.82 (VDD_7), IC301.91 (VDD_8), IC301.103 (VDD_9), IC301.114 (VDD_10), IC301.127 (VDD_11), IC301.136 (VDD_12), IC301.149 (VDD_13), IC301.159 (VDD_14), IC301.172 (VDD_15), J3.1 (VTref), J301.1, J301.2, R2.1, R5.1, R6.1, R305.1, TP301.1; also elsewhere on the board
+5V: R307.1, R309.1, R310.1, SW303.2, SW305.2, SW306.2; also elsewhere on the board
/IO Circuits/AMP_I2S2_CK: IC301.93 (PB13); also elsewhere on the board
/IO Circuits/AMP_I2S2_SD: IC301.95 (PB15); also elsewhere on the board
/IO Circuits/AMP_I2S2_WS: IC301.92 (PB12); also elsewhere on the board
/IO Circuits/LCD_Data/Command: IC301.120 (PA9); also elsewhere on the board
/IO Circuits/LCD_RST: IC301.119 (PA8); also elsewhere on the board
/IO Circuits/MIC_I2S3_SCK: IC301.139 (PC10); also elsewhere on the board
/IO Circuits/MIC_I2S3_SD: IC301.141 (PC12); also elsewhere on the board
/IO Circuits/MIC_I2S3_WS: IC301.138 (PA15); also elsewhere on the board
/IO Circuits/SPI1_MOSI: IC301.53 (PA7); also elsewhere on the board
/IO Circuits/SPI1_NSS: IC301.50 (PA4); also elsewhere on the board
/IO Circuits/SPI1_SCK: IC301.51 (PA5); also elsewhere on the board
/IO Circuits/SPI4_CSn: IC301.131 (PI0); also elsewhere on the board
/IO Circuits/SPI4_MISO: IC301.34 (PC2); also elsewhere on the board
/IO Circuits/SPI4_MOSI: IC301.35 (PC3); also elsewhere on the board
/IO Circuits/SPI4_SCLK: IC301.79 (PB10); also elsewhere on the board
/IO Circuits/SPI_MISO: IC301.52 (PA6); also elsewhere on the board
/MCU/JTCK/SWCLK: IC301.129 (PH14), J3.4 (SWDCLK/TCK), R2.2
/MCU/JTDO/TRACESWO: IC301.161 (PB3), J3.6 (SWO/TDO), R6.2
/MCU/JTMS/SWDIO: IC301.124 (PA13), J3.2 (SWDIO/TMS), R5.2
/MCU/NRST: C306.1, IC301.31 (NRST), J3.10 (~RESET), R305.2, SW301.2
/MCU/OSC_IN: C302.2, IC301.29 (PH0), Y301.1
/MCU/OSC_OUT: C301.2, IC301.30 (PH1), Y301.2
BOOT0: IC301.166 (BOOT0), J301.3, R301.1
BOOT1: IC301.58 (PB2), J301.4, R303.1
GND: C301.1, C302.1, C303.2, C304.2, C305.2, C306.2, C307.2, C308.2, C309.2, IC301.14 (VSS_1), IC301.61 (VSS_3), IC301.71 (VSS_4), IC301.90 (VSS_5), IC301.102 (VSS_6), IC301.113 (VSS_7), IC301.126 (VSS_8), IC301.135 (VSS_9), IC301.148 (VSS_10), IC301.158 (VSS_11), J3.3 (GND), J3.5 (GND), J3.9 (GNDDetect), J301.5, J301.6, R301.2, R303.2, R307.2, R309.2, R310.2, SW301.1; also elsewhere on the board
unnamed: IC301.122 (PA11), SW306.1
unnamed: IC301.151 (PD7), SW303.1
unnamed: IC301.152 (PG9), SW305.1

Notes on the sheet:
Microcontroller
I2S2 = AMP+SPKER I2S3 = MIC SPI = LCD SPI2 = RPI CM5
Connect 4.7u cap to V_dd3 (pin 48)
Debug Header

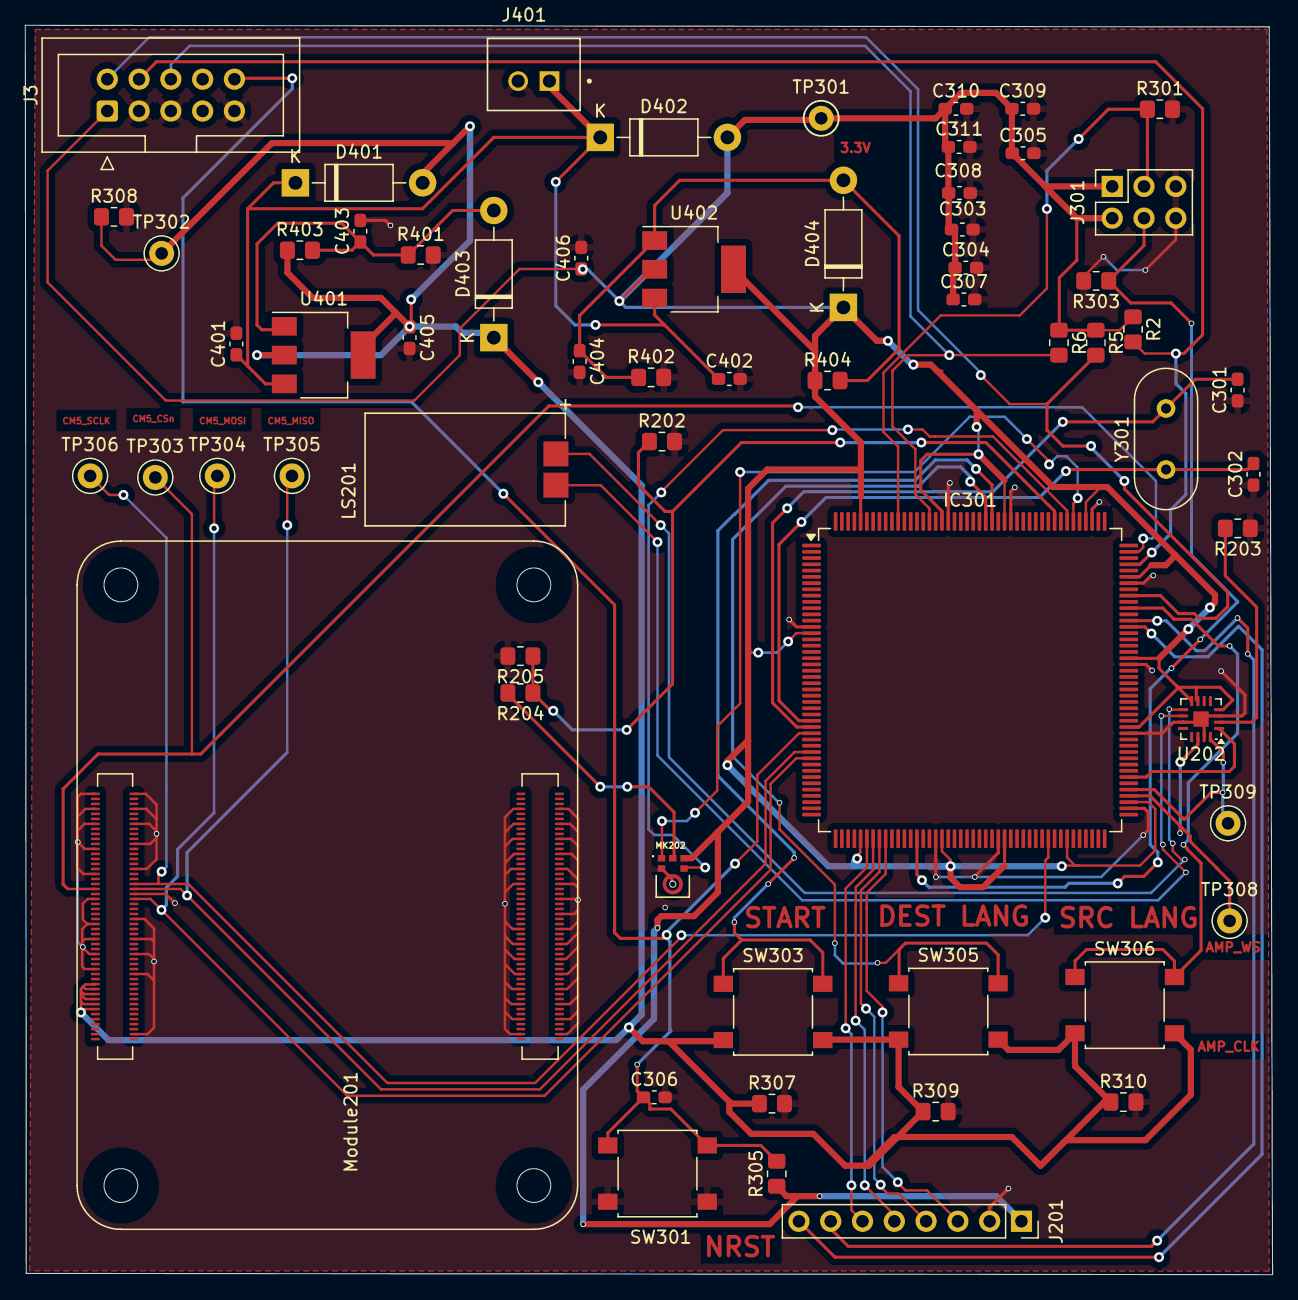
[picture p40: board Portable Offline Translator.kicad_pcb from above]

Board: 2 copper layers, 99.7 x 99.8 mm, 63 parts (0 on the bottom side), 37 nets.

Other parts of the board:
C310: 10n; C_0603_1608Metric_Pad1.08x0.95mm_HandSolder
C311: 1u; C_0603_1608Metric_Pad1.08x0.95mm_HandSolder
R202: 100k; R_0805_2012Metric_Pad1.20x1.40mm_HandSolder
R308: 10k; R_0805_2012Metric_Pad1.20x1.40mm_HandSolder

Their connections:
+3.3V: C310.1, C311.1; also elsewhere on the board
+5V: R308.1; also elsewhere on the board
/IO Circuits/MIC_I2S3_SD: R202.1; also elsewhere on the board
GND: C310.2, C311.2, R202.2, R308.2; also elsewhere on the board
