zobuj/PortableOfflineTranslator/src/rspcm/pipeline/main.cpp

#include "../whisper.cpp/include/whisper.h"
#include "../llama.cpp/include/llama.h"

#include <thread>
#include <string>
#include <vector>
#include <signal.h>
#include <sstream>
#include <iostream>
#include <fstream>
#include <unistd.h>
#include <time.h>
#include <map>
#include <sys/socket.h>
#include <sys/un.h>

volatile sig_atomic_t do_translate = 0;

void handle_sigusr1(int signum) {
    do_translate = 1;  
}

void cleanup(int signum) {
    fprintf(stdout, "Shutting down pipeline...\n");
    exit(EXIT_SUCCESS);
}

static const std::map<std::string, std::pair<int, std::string>> lang_map = {
    { "English",        { 0,  "en" } },
    { "Chinese",        { 1,  "zh" } },
    { "German",         { 2,  "de" } },
    { "Spanish",        { 3,  "es" } },
    { "Russian",        { 4,  "ru" } },
    { "Korean",         { 5,  "ko" } },
    { "French",         { 6,  "fr" } },
    { "Japanese",       { 7,  "ja" } },
    { "Portuguese",     { 8,  "pt" } },
    { "Turkish",        { 9,  "tr" } },
    { "Polish",         { 10, "pl" } },
    { "Catalan",        { 11, "ca" } },
    { "Dutch",          { 12, "nl" } },
    { "Arabic",         { 13, "ar" } },
    { "Swedish",        { 14, "sv" } },
    { "Italian",        { 15, "it" } },
    { "Indonesian",     { 16, "id" } },
    { "Hindi",          { 17, "hi" } },
    { "Finnish",        { 18, "fi" } },
    { "Vietnamese",     { 19, "vi" } },
    { "Hebrew",         { 20, "he" } },
    { "Ukrainian",      { 21, "uk" } },
    { "Greek",          { 22, "el" } },
    { "Malay",          { 23, "ms" } },
    { "Czech",          { 24, "cs" } },
    { "Romanian",       { 25, "ro" } },
    { "Danish",         { 26, "da" } },
    { "Hungarian",      { 27, "hu" } },
    { "Tamil",          { 28, "ta" } },
    { "Norwegian",      { 29, "no" } },
    { "Thai",           { 30, "th" } },
    { "Urdu",           { 31, "ur" } },
    { "Croatian",       { 32, "hr" } },
    { "Bulgarian",      { 33, "bg" } },
    { "Lithuanian",     { 34, "lt" } },
    { "Latin",          { 35, "la" } },
    { "Maori",          { 36, "mi" } },
    { "Malayalam",      { 37, "ml" } },
    { "Welsh",          { 38, "cy" } },
    { "Slovak",         { 39, "sk" } },
    { "Telugu",         { 40, "te" } },
    { "Persian",        { 41, "fa" } },
    { "Latvian",        { 42, "lv" } },
    { "Bengali",        { 43, "bn" } },
    { "Serbian",        { 44, "sr" } },
    { "Azerbaijani",    { 45, "az" } },
    { "Slovenian",      { 46, "sl" } },
    { "Kannada",        { 47, "kn" } },
    { "Estonian",       { 48, "et" } },
    { "Macedonian",     { 49, "mk" } },
    { "Breton",         { 50, "br" } },
    { "Basque",         { 51, "eu" } },
    { "Icelandic",      { 52, "is" } },
    { "Armenian",       { 53, "hy" } },
    { "Nepali",         { 54, "ne" } },
    { "Mongolian",      { 55, "mn" } },
    { "Bosnian",        { 56, "bs" } },
    { "Kazakh",         { 57, "kk" } },
    { "Albanian",       { 58, "sq" } },
    { "Swahili",        { 59, "sw" } },
    { "Galician",       { 60, "gl" } },
    { "Marathi",        { 61, "mr" } },
    { "Punjabi",        { 62, "pa" } },
    { "Sinhala",        { 63, "si" } },
    { "Khmer",          { 64, "km" } },
    { "Shona",          { 65, "sn" } },
    { "Yoruba",         { 66, "yo" } },
    { "Somali",         { 67, "so" } },
    { "Afrikaans",      { 68, "af" } },
    { "Occitan",        { 69, "oc" } },
    { "Georgian",       { 70, "ka" } },
    { "Belarusian",     { 71, "be" } },
    { "Tajik",          { 72, "tg" } },
    { "Sindhi",         { 73, "sd" } },
    { "Gujarati",       { 74, "gu" } },
    { "Amharic",        { 75, "am" } },
    { "Yiddish",        { 76, "yi" } },
    { "Lao",            { 77, "lo" } },
    { "Uzbek",          { 78, "uz" } },
    { "Faroese",        { 79, "fo" } },
    { "Haitian Creole", { 80, "ht" } },
    { "Pashto",         { 81, "ps" } },
    { "Turkmen",        { 82, "tk" } },
    { "Nynorsk",        { 83, "nn" } },
    { "Maltese",        { 84, "mt" } },
    { "Sanskrit",       { 85, "sa" } },
    { "Luxembourgish",  { 86, "lb" } },
    { "Myanmar",        { 87, "my" } },
    { "Tibetan",        { 88, "bo" } },
    { "Tagalog",        { 89, "tl" } },
    { "Malagasy",       { 90, "mg" } },
    { "Assamese",       { 91, "as" } },
    { "Tatar",          { 92, "tt" } },
    { "Hawaiian",       { 93, "haw" } },
    { "Lingala",        { 94, "ln" } },
    { "Hausa",          { 95, "ha" } },
    { "Bashkir",        { 96, "ba" } },
    { "Javanese",       { 97, "jw" } },
    { "Sundanese",      { 98, "su" } },
    { "Cantonese",      { 99, "yue" } },
};

// Whisper Parameters - stream.cpp
struct whisper_params {
    int32_t n_threads  = std::min(4, (int32_t) std::thread::hardware_concurrency());
    int32_t step_ms    = 3000;
    int32_t length_ms  = 10000;
    int32_t keep_ms    = 200;
    int32_t capture_id = -1;
    int32_t max_tokens = 32;
    int32_t audio_ctx  = 0;

    float vad_thold    = 0.6f;
    float freq_thold   = 100.0f;

    bool translate     = false;
    bool no_fallback   = false;
    bool print_special = false;
    bool no_context    = true;
    bool no_timestamps = false;
    bool tinydiarize   = false;
    bool save_audio    = false; // save audio to wav file
    bool use_gpu       = true;
    bool flash_attn    = false;

    std::string language  = "en";
    std::string model     = "/Users/lorenzobujalilsilva/Documents/school/ECE445/translator/src/rspcm/whisper.cpp/models/ggml-tiny.bin";
    std::string fname_out = "";
};

std::string transcribe(std::string lang){
    
    whisper_params params;

    params.language = lang;

    params.keep_ms   = std::min(params.keep_ms,   params.step_ms);
    params.length_ms = std::max(params.length_ms, params.step_ms);

    const int n_samples_step = (1e-3*params.step_ms  )*WHISPER_SAMPLE_RATE;
    const int n_samples_len  = (1e-3*params.length_ms)*WHISPER_SAMPLE_RATE;
    const int n_samples_keep = (1e-3*params.keep_ms  )*WHISPER_SAMPLE_RATE;
    const int n_samples_30s  = (1e-3*30000.0         )*WHISPER_SAMPLE_RATE;

    const bool use_vad = n_samples_step <= 0; // sliding window mode uses VAD

    const int n_new_line = !use_vad ? std::max(1, params.length_ms / params.step_ms - 1) : 1; // number of steps to print new line

    params.no_timestamps  = !use_vad;
    params.no_context    |= use_vad;
    params.max_tokens     = 0;

    // whisper init
    if (params.language != "auto" && whisper_lang_id(params.language.c_str()) == -1){
        fprintf(stderr, "Error: unknown language '%s'\n", params.language.c_str());
        exit(0);
    }

    struct whisper_context_params cparams = whisper_context_default_params();

    cparams.use_gpu    = params.use_gpu;
    cparams.flash_attn = params.flash_attn;

    struct whisper_context * ctx = whisper_init_from_file_with_params(params.model.c_str(), cparams);

    std::vector<float> pcmf32;

    // Processing Info - stream.cpp
    {
        fprintf(stderr, "\n");
        if (!whisper_is_multilingual(ctx)) {
            if (params.language != "en" || params.translate) {
                params.language = "en";
                params.translate = false;
                fprintf(stderr, "%s: WARNING: model is not multilingual, ignoring language and translation options\n", __func__);
            }
        }
        fprintf(stderr, "%s: processing %d samples (step = %.1f sec / len = %.1f sec / keep = %.1f sec), %d threads, lang = %s, task = %s, timestamps = %d ...\n",
                __func__,
                n_samples_step,
                float(n_samples_step)/WHISPER_SAMPLE_RATE,
                float(n_samples_len )/WHISPER_SAMPLE_RATE,
                float(n_samples_keep)/WHISPER_SAMPLE_RATE,
                params.n_threads,
                params.language.c_str(),
                params.translate ? "translate" : "transcribe",
                params.no_timestamps ? 0 : 1);

        if (!use_vad) {
            fprintf(stderr, "%s: n_new_line = %d, no_context = %d\n", __func__, n_new_line, params.no_context);
        } else {
            fprintf(stderr, "%s: using VAD, will transcribe on speech activity\n", __func__);
        }

        fprintf(stderr, "\n");
    }

    // Read PCM Data 
    {
        std::string pcm_filename = "/Users/lorenzobujalilsilva/Documents/school/ECE445/translator/src/spi_interface/recording_input.pcm";
        std::ifstream pcm_file(pcm_filename, std::ios::binary);
        
        if (!pcm_file) {
            fprintf(stderr, "Error: Unable to open %s!\n", pcm_filename.c_str());
            return "";
        }

        std::vector<int16_t> pcm16;
        int16_t sample;
    
        while (pcm_file.read(reinterpret_cast<char*>(&sample), sizeof(int16_t))) {
            pcm16.push_back(sample);
        }
    
        pcm_file.close();
    
        fprintf(stdout, "Read %zu samples from %s\n", pcm16.size(), pcm_filename.c_str());
    
        pcmf32.resize(pcm16.size());
    
        for (size_t i = 0; i < pcm16.size(); ++i) {
            // Normalize to [-1, 1]
            pcmf32[i] = static_cast<float>(pcm16[i]) / 32768.0f;
        }
    }

    // Run the inference - stream.cpp
    {
        whisper_full_params wparams = whisper_full_default_params(WHISPER_SAMPLING_GREEDY);

        wparams.print_progress   = false;
        wparams.print_special    = params.print_special;
        wparams.print_realtime   = false;
        wparams.print_timestamps = !params.no_timestamps;
        wparams.translate        = params.translate;
        wparams.single_segment   = !use_vad;
        wparams.max_tokens       = params.max_tokens;
        wparams.language         = params.language.c_str();
        wparams.n_threads        = params.n_threads;

        wparams.audio_ctx        = params.audio_ctx;

        wparams.tdrz_enable      = params.tinydiarize; // [TDRZ]
        wparams.temperature_inc  = params.no_fallback ? 0.0f : wparams.temperature_inc;


        if (whisper_full(ctx, wparams, pcmf32.data(), pcmf32.size()) != 0) {
            fprintf(stderr, "%s: failed to process audio\n", __func__);
            return "";
        }

        // print result; - stream.cpp (DEBUGGING)
        std::ostringstream result;

        {
            const int n_segments = whisper_full_n_segments(ctx);
            for (int i = 0; i < n_segments; ++i) {
                const char * text = whisper_full_get_segment_text(ctx, i);
                printf("%s\n", text);
                result << text << " ";
            }
        }
        return result.str();
    }
}

int translate(const std::string &text_in, std::string &text_out, std::string &dest_langauge) {
    // Escape double quotes inside the input text
    std::string escaped_text = text_in;
    size_t pos = 0;
    while ((pos = escaped_text.find("\"", pos)) != std::string::npos) {
        escaped_text.replace(pos, 1, "\\\"");
        pos += 2;  // Move past the escaped quote
    }

    // path to the model gguf file
    std::string model_path = "/Users/lorenzobujalilsilva/Documents/school/ECE445/translator/src/rspcm/llama.cpp/models/mistral-7b.Q4_K_M.gguf";
    // prompt to generate text from
    std::string prompt = "-p Translate the following text to " + dest_langauge + ": ' " + escaped_text + " ' --reverse-prompt " + dest_langauge + ":";
    // number of layers to offload to the GPU
    int ngl = 99;
    // number of tokens to predict
    int n_predict = 32;

    // load dynamic backends

    ggml_backend_load_all();

    // initialize the model

    llama_model_params model_params = llama_model_default_params();
    model_params.n_gpu_layers = ngl;

    llama_model * model = llama_model_load_from_file(model_path.c_str(), model_params);
    const llama_vocab * vocab = llama_model_get_vocab(model);

    if (model == NULL) {
        fprintf(stderr , "%s: Error: unable to load model\n" , __func__);
        return 1;
    }

    // tokenize the prompt

    // find the number of tokens in the prompt
    const int n_prompt = -llama_tokenize(vocab, prompt.c_str(), prompt.size(), NULL, 0, true, true);

    // allocate space for the tokens and tokenize the prompt
    std::vector<llama_token> prompt_tokens(n_prompt);
    if (llama_tokenize(vocab, prompt.c_str(), prompt.size(), prompt_tokens.data(), prompt_tokens.size(), true, true) < 0) {
        fprintf(stderr, "%s: Error: failed to tokenize the prompt\n", __func__);
        return 1;
    }

    // initialize the context

    llama_context_params ctx_params = llama_context_default_params();
    // n_ctx is the context size
    ctx_params.n_ctx = n_prompt + n_predict - 1;
    // n_batch is the maximum number of tokens that can be processed in a single call to llama_decode
    ctx_params.n_batch = n_prompt;
    // enable performance counters
    ctx_params.no_perf = false;

    llama_context * ctx = llama_init_from_model(model, ctx_params);

    if (ctx == NULL) {
        fprintf(stderr , "%s: Error: failed to create the llama_context\n" , __func__);
        return 1;
    }

    // initialize the sampler

    auto sparams = llama_sampler_chain_default_params();
    sparams.no_perf = false;
    llama_sampler * smpl = llama_sampler_chain_init(sparams);

    llama_sampler_chain_add(smpl, llama_sampler_init_greedy());

    // print the prompt token-by-token

    for (auto id : prompt_tokens) {
        char buf[128];
        int n = llama_token_to_piece(vocab, id, buf, sizeof(buf), 0, true);
        if (n < 0) {
            fprintf(stderr, "%s: Error: failed to convert token to piece\n", __func__);
            return 1;
        }
        std::string s(buf, n);
        printf("%s", s.c_str());
    }

    // prepare a batch for the prompt

    llama_batch batch = llama_batch_get_one(prompt_tokens.data(), prompt_tokens.size());

    // main loop

    const auto t_main_start = ggml_time_us();
    int n_decode = 0;
    llama_token new_token_id;

    std::string generated_text;  // String to store accumulated tokens

    for (int n_pos = 0; n_pos + batch.n_tokens < n_prompt + n_predict; ) {
        // evaluate the current batch with the transformer model
        if (llama_decode(ctx, batch)) {
            fprintf(stderr, "%s : failed to eval, return code %d\n", __func__, 1);
            return 1;
        }

        n_pos += batch.n_tokens;

        // sample the next token
        {
            new_token_id = llama_sampler_sample(smpl, ctx, -1);
        
            // is it an end of generation?
            if (llama_vocab_is_eog(vocab, new_token_id)) {
                break;
            }
        
            char buf[128];
            int n = llama_token_to_piece(vocab, new_token_id, buf, sizeof(buf), 0, true);
            if (n < 0) {
                fprintf(stderr, "%s: Error: failed to convert token to piece\n", __func__);
                return 1;
            }
        
            generated_text.append(buf, n);  // Append token to the accumulated string
        
            // prepare the next batch with the sampled token
            batch = llama_batch_get_one(&new_token_id, 1);
        
            n_decode += 1;
        }
        
        
    }

    printf("\n");

    text_out = generated_text;

    const auto t_main_end = ggml_time_us();

    fprintf(stderr, "%s: decoded %d tokens in %.2f s, speed: %.2f t/s\n",
            __func__, n_decode, (t_main_end - t_main_start) / 1000000.0f, n_decode / ((t_main_end - t_main_start) / 1000000.0f));

    fprintf(stderr, "\n");
    llama_perf_sampler_print(smpl);
    llama_perf_context_print(ctx);
    fprintf(stderr, "\n");

    llama_sampler_free(smpl);
    llama_free(ctx);
    llama_model_free(model);

    return 0;
}

#include <fstream>
#include <iostream>
#include <string>

void get_language_config(std::string &source_lang, std::string &dest_lang) {
    std::ifstream config("/Users/lorenzobujalilsilva/Documents/school/ECE445/translator/src/user_interface/lcd/config.txt");
    
    if (!config) {
        std::cerr << "Error opening config.txt" << std::endl;
        return;
    }

    std::string line;
    while (std::getline(config, line)) {
        if (line.rfind("source=", 0) == 0) {
            source_lang = line.substr(7); // strip "source="
        } else if (line.rfind("destination=", 0) == 0) {
            dest_lang = line.substr(12); // strip "destination="
        }
    }

    config.close();
}

int main(int argc, char ** argv){
    signal(SIGINT, cleanup);
    signal(SIGUSR1, handle_sigusr1);

    fprintf(stdout, "Starting Translation Pipeline...\n");

    while(1){
        fprintf(stdout, "Waiting for translation request from MCU...\n");
        fprintf(stdout, "Press Ctrl+C to exit.\n");
        
        pause();  // Wait until SIGUSR1
        if (do_translate) {
            do_translate = 0;
            
            // Start Timing Transaction
            struct timespec start, end;
            double elapsed_time;
            
            fprintf(stdout, "Processing Translation Request...\n");
            
            clock_gettime(CLOCK_MONOTONIC, &start);
            
            std::string source_language;
            std::string dest_language;
            
            get_language_config(source_language, dest_language);
            
            fprintf(stdout, "Source Language: %s\n", source_language.c_str());
            fprintf(stdout, "Destination Language: %s\n", dest_language.c_str());
            
            
            std::string transcribed_text = transcribe(lang_map.at(source_language).second); //whisper
            
            std::ofstream out("/Users/lorenzobujalilsilva/Documents/school/ECE445/translator/src/user_interface/lcd/transcribed_text.txt");
            if (out.is_open()) {
                out << transcribed_text;
                out.close();
            } else {
                std::cerr << "Failed to write to /Users/lorenzobujalilsilva/Documents/school/ECE445/translator/src/user_interface/lcd/transcribed_text.txt\n";
            }

            std::ifstream pidfile("/Users/lorenzobujalilsilva/Documents/school/ECE445/translator/src/user_interface/lcd/lcd_display.pid");
            if (pidfile.is_open()) {
                int pid;
                pidfile >> pid;
                pidfile.close();
            
                std::string cmd = "sudo kill -SIGUSR1 " + std::to_string(pid);
                int ret = system(cmd.c_str());
            
                if (ret == 0) {
                    std::cout << "Sent SIGUSR1 to display process (PID " << pid << ") using sudo\n";
                } else {
                    std::cerr << "Failed to send SIGUSR1 using sudo (exit code " << ret << ")\n";
                }
            } else {
                std::cerr << "Failed to read PID file\n";
            }

            std::string translated_text;
            translate(transcribed_text, translated_text, dest_language); //llama
            
            fprintf(stdout, "\nTranscribed text (%s): \033[0;36m%s\033[0m\n\n", source_language.c_str(),transcribed_text.c_str());
            fprintf(stdout, "Translated text (%s): \033[0;32m%s\033[0m\n\n", dest_language.c_str(), translated_text.c_str());
            
            // Output the translated text to a file
            std::ofstream output_file("/Users/lorenzobujalilsilva/Documents/school/ECE445/translator/src/rspcm/output/translated_text.txt"); 
            if (!output_file) {
                fprintf(stderr, "Error: Unable to open output file for writing.\n");
            } else {
                output_file << translated_text;
                output_file.close();
                fprintf(stdout, "Translated text has been written to /Users/lorenzobujalilsilva/Documents/school/ECE445/translator/src/rspcm/output/translated_text.txt\n");
            }
            
            // Text to Speech
            std::string tts_command = "bash /Users/lorenzobujalilsilva/Documents/school/ECE445/translator/src/rspcm/piper/voices/tts.sh \"" + dest_language + "\"";

            int ret = system(tts_command.c_str());
            
            if (ret != 0) {
                fprintf(stderr, "Error: TTS command failed.\n");
            }
        
            // Read the PID of the SPI interface process
            const char* pid_file_path = "/Users/lorenzobujalilsilva/Documents/school/ECE445/translator/src/spi_interface/spi_interface.pid";
            std::ifstream pid_file(pid_file_path);
            if (!pid_file.is_open()) {
                fprintf(stderr, "Error: Could not open PID file.\n");
                return 1;
            }

            int spi_pid;
            pid_file >> spi_pid;
            pid_file.close();
        
            // Send SIGUSR1 to the SPI process
            if (kill(spi_pid, SIGUSR1) != 0) {
                perror("Error sending SIGUSR1");
                return 1;
            }
        
            printf("Sent SIGUSR1 to SPI interface process (PID %d)\n", spi_pid);

            clock_gettime(CLOCK_MONOTONIC, &end);
            
            elapsed_time = (end.tv_sec - start.tv_sec) + (end.tv_nsec - start.tv_nsec) / 1e9;
            
            fprintf(stdout, "Translation complete. Time taken: %.6f seconds.\n", elapsed_time);
            fprintf(stdout, "Returning to idle state.\n");
        }
    }

    return 0;
}
