zobuj/PortableOfflineTranslator/(commit log)

2025-02-06 Raspberry Pi CM documentation
2025-02-11 Power SS added to drawio
2025-02-19 Interrupt Based Driven pipeline working, build system is setup aswell
2025-02-20 First transcription done from sample.pcm
2025-02-20 changed to 24 bit and now have some framework for debugging the speech
2025-02-25 working with speech
    [config.txt]
2025-02-26 Added KiCad files
    [Portable Offline Translator.kicad_pcb, Portable Offline Translator.kicad_sch]
2025-02-26 KiCad files added pt2
    [Portable Offline Translator.kicad_sch]
2025-02-27 MCU and Power SS updated
    [Portable Offline Translator.kicad_sch]
2025-02-27 IO schematic in prog
    [IO.kicad_sch, MCU.kicad_sch, Portable Offline Translator.kicad_sch, powerSS.kicad_sch]
2025-03-07 Added Datasheets and PCB
    [IO.kicad_sch, MCU.kicad_sch, Portable Offline Translator.kicad_pcb, Portable Offline Translator.kicad_sch, powerSS.kicad_sch]
2025-03-10 PCB Backup
    [10164227-1001A1RLF.step, BOM.xlsx, IO.kicad_sch, MCU.kicad_sch, Portable Offline Translator.kicad_pcb, Portable Offline Translator.kicad_sch]
2025-03-13 PCB iteration 1
    [EDI2CAP.CFG, MAX98357AETE_T.step, MCU.kicad_sch, Portable Offline Translator.kicad_pcb, Portable Offline Translator.kicad_sch, chips.prt, powerSS.kicad_sch, qfp50p2600x2600x160-176n.psm]
2025-03-13 PCB iteration1 gerber and drill files added
    [Portable Offline Translator-B_Cu.gbr, Portable Offline Translator-B_Mask.gbr, Portable Offline Translator-B_Paste.gbr, Portable Offline Translator-B_Silkscreen.gbr, Portable Offline Translator-Edge_Cuts.gbr, Portable Offline Translator-F_Cu.gbr, Portable Offline Translator-F_Mask.gbr, Portable Offline Translator-F_Paste.gbr]
2025-03-22 updated some content in the lcd
    [config.txt]
2025-03-22 WIP: Local changes before pulling
    [config.txt]
2025-04-03 main PCB v1 done
    [B2B-XH-A.step, IO.kicad_sch, MCU.kicad_sch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]
2025-04-09 adding button interrupt funcitonality
2025-04-21 made some changes to the spi interfaces
2025-04-21 currently working for display
2025-04-22 working on pi
    [config.txt]
2025-05-01 U DONT LIKE THAT ARNAYYYY
    [ESP32-S3-WROOM-1-N8R8.step, ESP32-S3.step, IO.kicad_sch, MCU.kicad_sch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]
2025-05-05 code working on the pi
    [config.txt]
2025-05-08 pcb_backup files
    [ESP32-S3-WROOM-1-N8R8.step, ESP32-S3.step, IO.kicad_sch, MCU.kicad_sch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]
2025-05-08 final changes
    [config.txt, pipeline_mem_log.csv]
2025-05-08 reformat git:
    [BOM.xlsx]
2025-05-08 github refactor
    [10164227-1001A1RLF.step, B2B-XH-A.step, EDI2CAP.CFG, ESP32-S3-WROOM-1-N8R8.step, ESP32-S3.step, IO.kicad_sch, MAX98357AETE_T.step, MCU.kicad_sch]
2025-05-08 cleaned up spi interface
